dandeeAndy/CapstoneDesign/UI기본.png

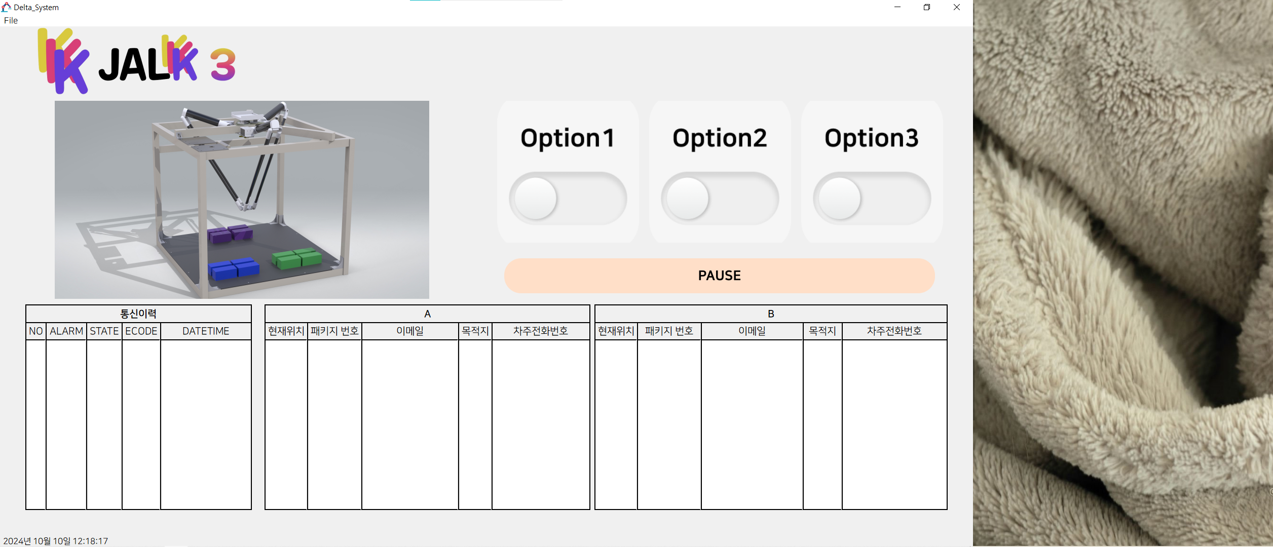
UI기본.png
