dandeeAndy/CapstoneDesign/hanium/엑스포/KakaoTalk_20241204_135034565_04.jpg

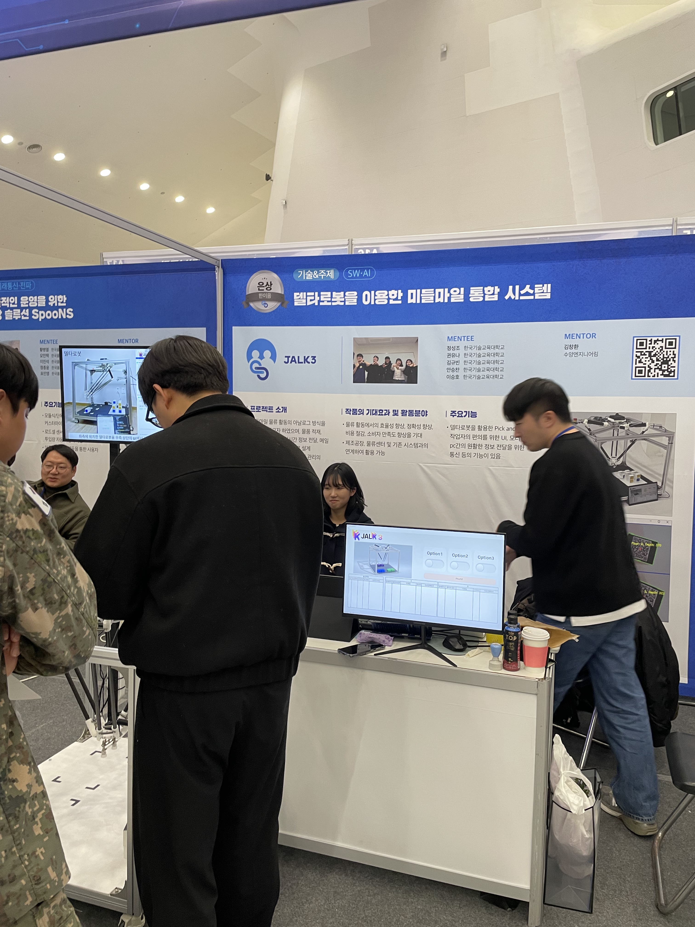
hanium/엑스포/KakaoTalk_20241204_135034565_04.jpg
