dandeeAndy/CapstoneDesign/Readme.txt

코드에 들어가는 (QPixmap)사진 파일 위치는 코드 안에서 다 특정할 수 있지만, 짧게 명료하게 쓰려면 같은 위치에 있어야 함.
->현재 디렉토리 확인 결과
C:\Users\schah\바탕 화면\Andy\Design\CapstoneDesign
