dandeeAndy/CapstoneDesign/한국기술교육대학교 산학협력단 사업자등록증_이규만.pdf

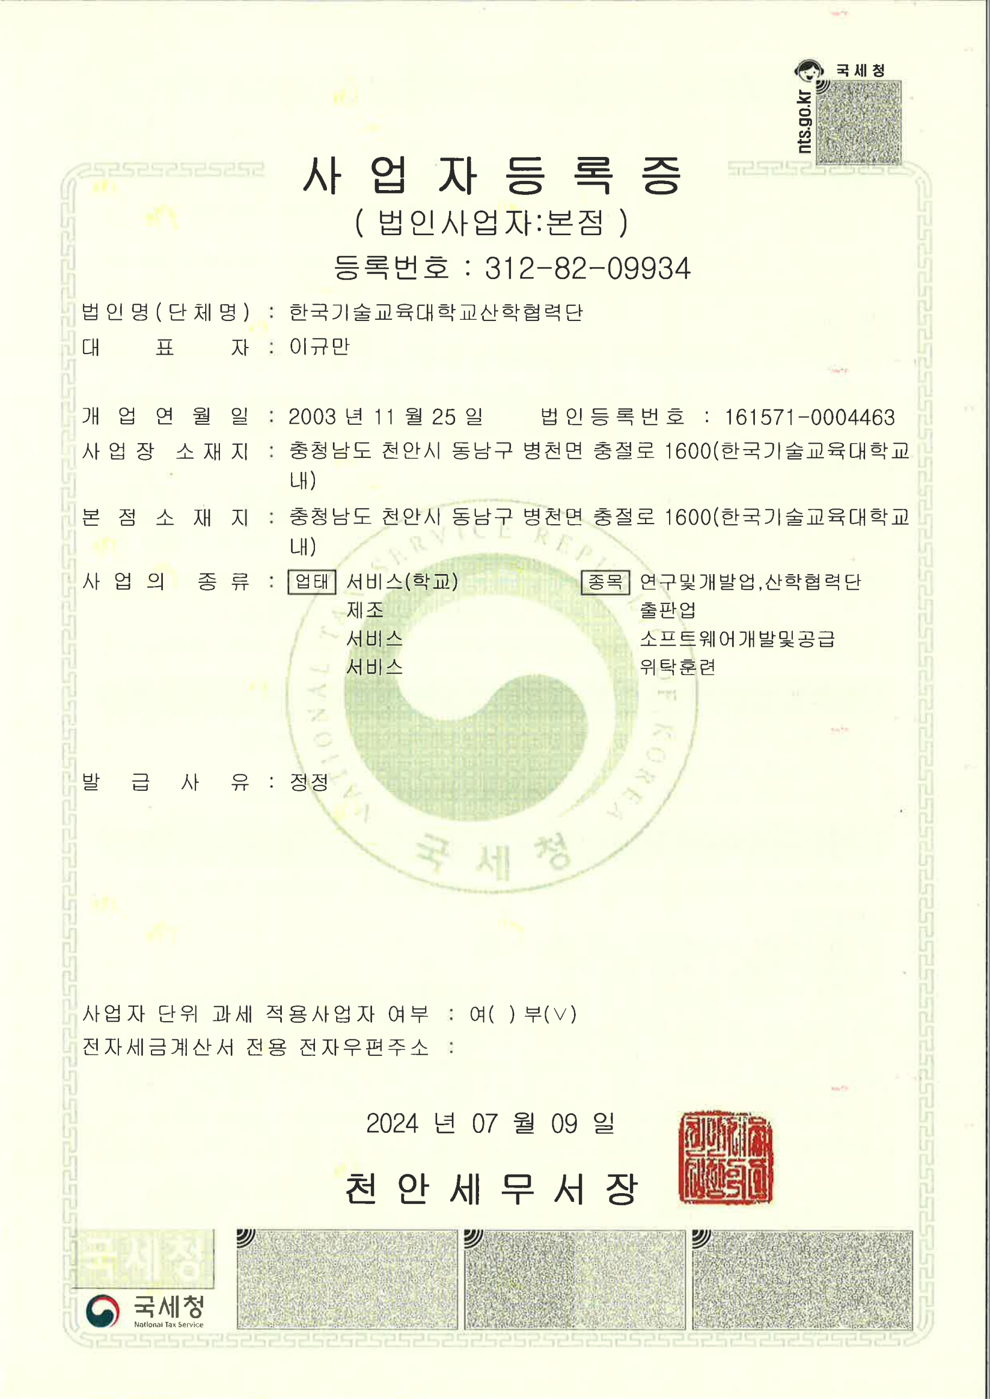
[picture p15: page 1]
