dandeeAndy/CapstoneDesign/hanium/ICT멘토링 레벨업 패스_이용 방법.pdf

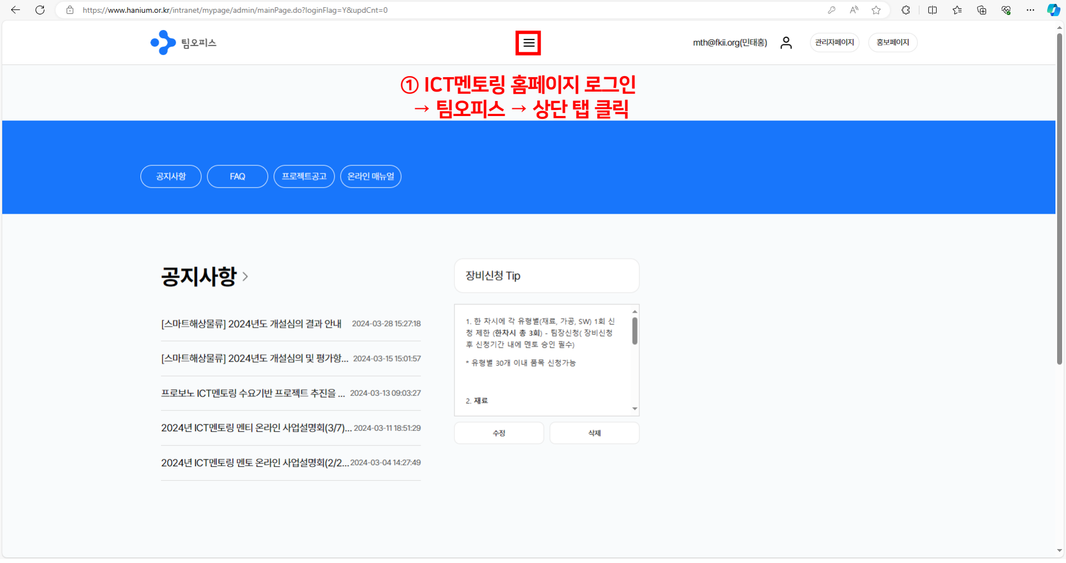
[picture p16: page 1]

① ICT멘토링 홈페이지 로그인
→ 팀오피스 → 상단 탭 클릭

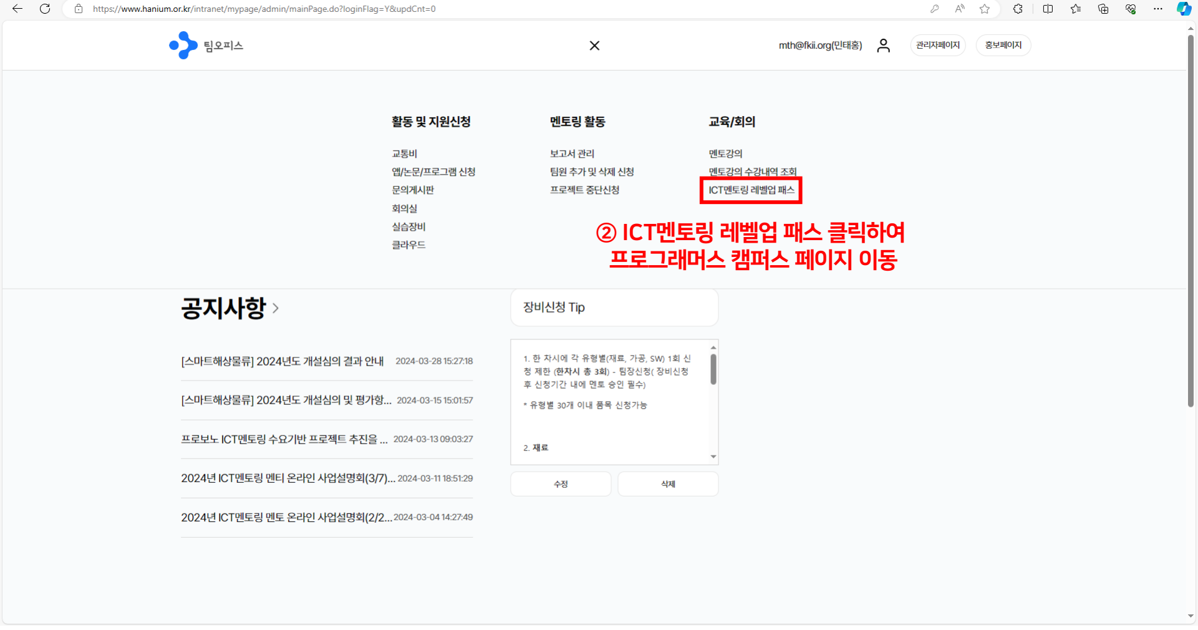
[picture p17: page 2]

② ICT멘토링 레벨업 패스 클릭하여
프로그래머스 캠퍼스 페이지 이동

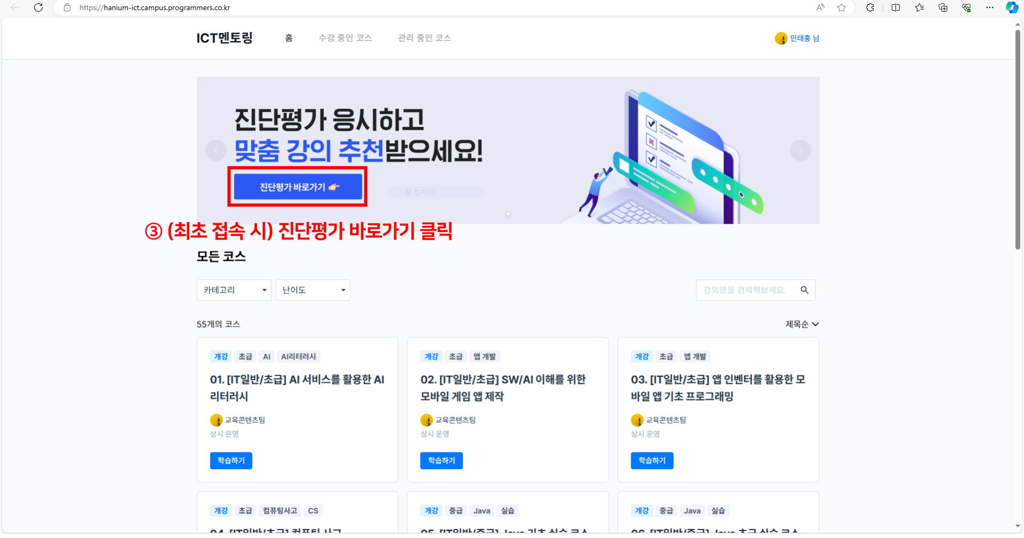
[picture p18: page 3]

③ (최초 접속 시) 진단평가 바로가기 클릭

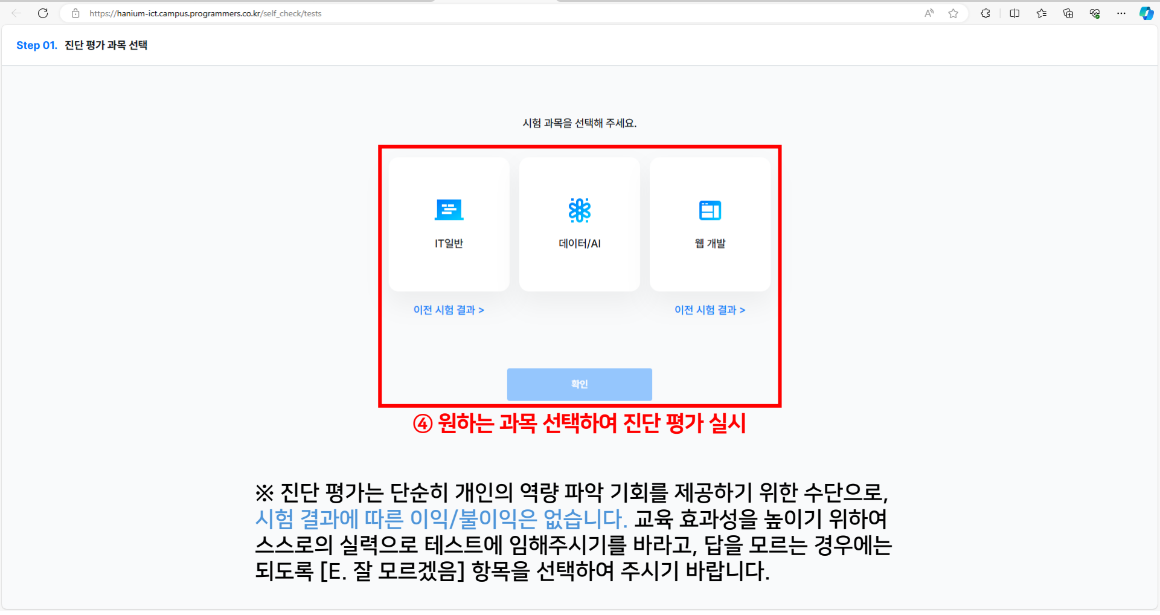
[picture p19: page 4]

④ 원하는 과목 선택하여 진단 평가 실시

※ 진단 평가는 단순히 개인의 역량 파악 기회를 제공하기 위한 수단으로, 시험 결과에 따른 이익/불이익은 없습니다. 교육 효과성을 높이기 위하여 스스로의 실력으로 테스트에 임해주시기를 바라고, 답을 모르는 경우에는 되도록 [E. 잘 모르겠음] 항목을 선택하여 주시기 바랍니다.

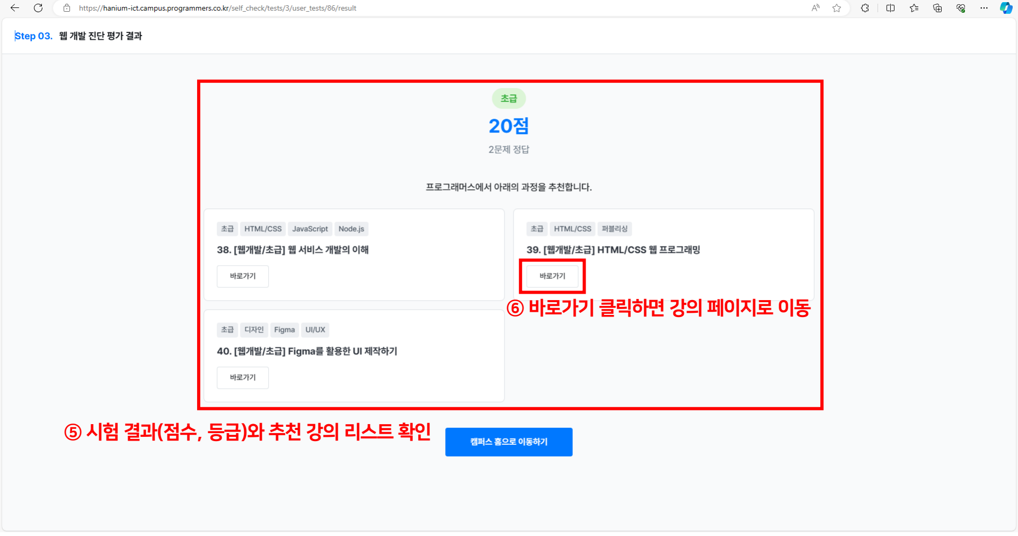
[picture p20: page 5]

⑤ 시험 결과(점수, 등급)와 추천 강의 리스트 확인

⑥ 바로가기 클릭하면 강의 페이지로 이동

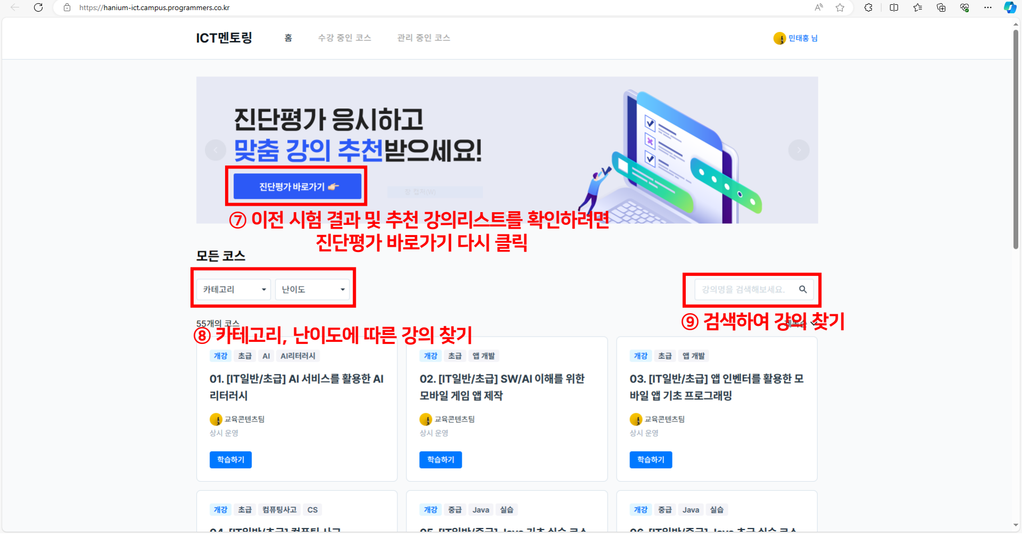
[picture p21: page 6]

⑧ 카테고리, 난이도에 따른 강의 찾기 | ⑨ 검색하여 강의 찾기

⑦ 이전 시험 결과 및 추천 강의리스트를 확인하려면
진단평가 바로가기 다시 클릭

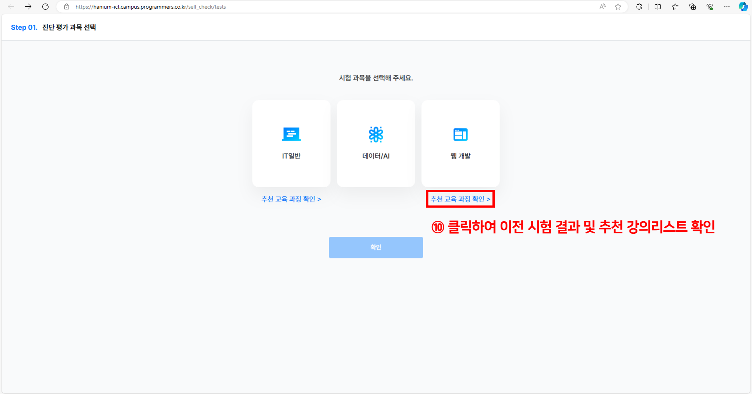
[picture p22: page 7]

⑩ 클릭하여 이전 시험 결과 및 추천 강의리스트 확인
