dandeeAndy/CapstoneDesign/기타파일/20240403(권유나님)견적서-아랫링크.pdf

NO : 20240403-D002

# 견 적 서

PAGE: | 1 / 1
권유나 귀하 견적일자 : 2024-04-03 견적요청에 감사드리며 아래 와 같이 견적합니다. | 공 급 자 | 등록번호 | 411-81-75485
상 호 | 주식회사 카본메이크 | 성 명 | 신학민
주 소 | 경기도 화성시 동탄첨단산업1로 63-12 (영천동) 비즈타워 312호
업 태 | 제조업 | 종 목 | 강화플라스틱성형
전화번호 | 070-7527-3444 | 팩스번호 | 030-3344-44545
순번 | 품목명 | 규격 | 수량 | 단가 | 공급가액 | 세액 | 비고
1 | 아랫링크(가공 포함) | 14*12*560 mm | 6 | 20,000 | 120,000 | 12,000
합계 | 120,000 | 12,000
납기일자 | 납품장소
유효일자 | 결제조건

비 고

합계금액 : 일금 일십삼만이천 원정 (￦ 132,000) (부가세포함)
