dandeeAndy/CapstoneDesign/졸설마무리/주간연구일지/주간연구일지_5주차.pdf

## 주간 연구 일지

교과목명 | 졸업설계 | 교과코드 | MEG895 | 분반 | 06
연구과제명 | 델타로봇을 이용한 미들마일 통합시스템
주차계획일정 | 4월 1주차 / 사용자 인터페이스(UI) 구축 및 사용자 경험(UX) 개발
일 시 | 2023년 04월 01일 (월) ~ 04월 07일 (일)
팀 원 | 성 명(사유) | | | 비고
참석자 | 정성조, 이승호, 안승찬, 권유나, 김규빈
불참자 | - 회의
안건 (작업 주제) | 1. UI 사용목적 2. UI 주요기능 구성

회의
(작업)
내용
1. UI 사용목적
- 연구목적
1) 사용자가 물류의 분류를 능동적으로 실시간 제어하기 위해서 UI를 개발해
- 연구과제 수행 과정 및 방법
1) 파이썬을 이용해 통신을 하기 위해서는 PyQt5를 이용해 개발해야 함. 우선, 피그마 (Figma)를 이용해 각 버튼의 이미지를 제작. 2. UI 주요기능 구성

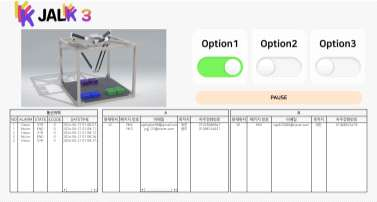
[picture p23: figure]

- UI가 실행되면 3가지 옵션 버튼을 누를 수 있게 함. 하나의 토글형 옵션 버튼을 누르 면 다른 옵션은 선택 불가하며, 바로 옵션에 따른 분류기준을 정해, 비전 카메라와 로봇 이 구동함. 아래의 구분된 ListLabel에 물류에 대한 정보가 한 줄씩 출력되어 도착위치와 함께 기록됨. 이후 작업 중지버튼을 누를시, 구동중인 루프만을 실행하고 비전 카메라와 로봇이 정지함. 이어 팝업된 리셋에 대한 안내창에서 ‘예’를 클릭시 옵션과 기록된 물류 정보를 모두 지우고 초기 상태로 돌아감. 추가로 모든 구동간에 비전 카메라 구동의 시 작과 모터 구동의 마무리 시점을 모두 기록해 통신이력을 남김. 결과/

지도교수 피드백

작성자 | 정성조 (인, 서명) | 지도교수 | 박성제 (인, 서명)
