dandeeAndy/CapstoneDesign/hanium/엑스포/KakaoTalk_20241204_165636019_14.jpg

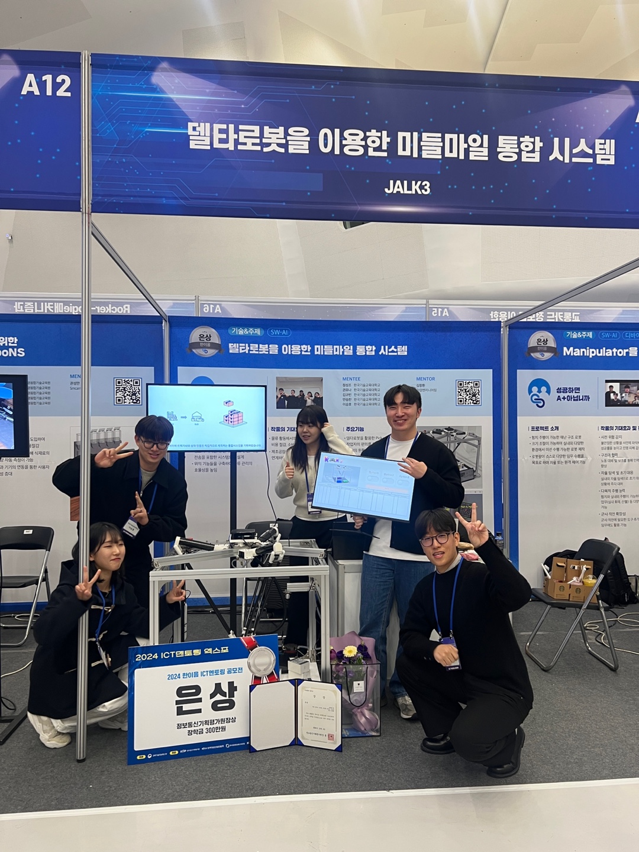
hanium/엑스포/KakaoTalk_20241204_165636019_14.jpg
