dandeeAndy/CapstoneDesign/hanium/엑스포/KakaoTalk_20241204_174310532.jpg

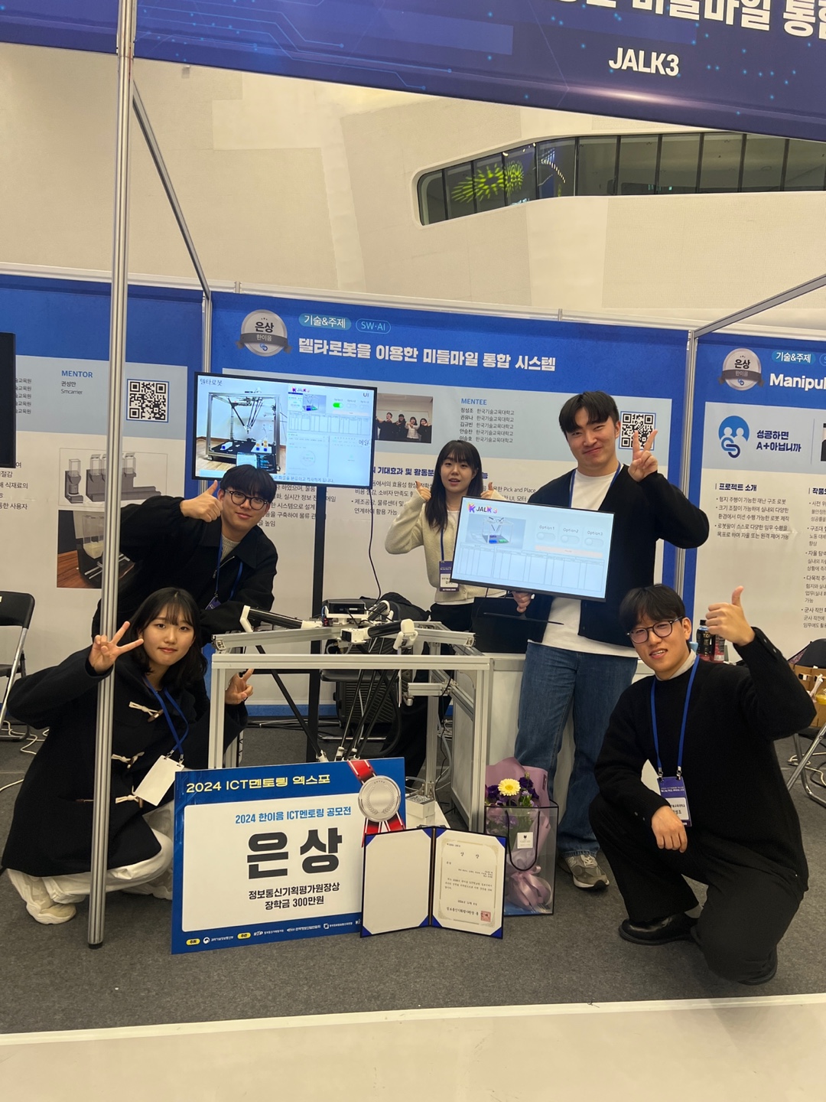
hanium/엑스포/KakaoTalk_20241204_174310532.jpg
