dandeeAndy/CapstoneDesign/hanium/엑스포/ktx영수증.png

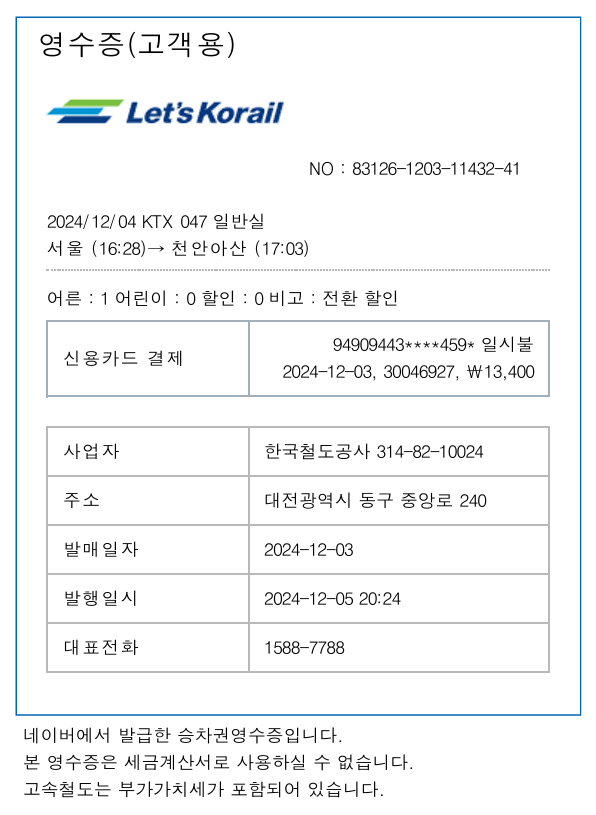
hanium/엑스포/ktx영수증.png
