dandeeAndy/CapstoneDesign/hanium/엑스포/Receipt_1733665486213.jpg

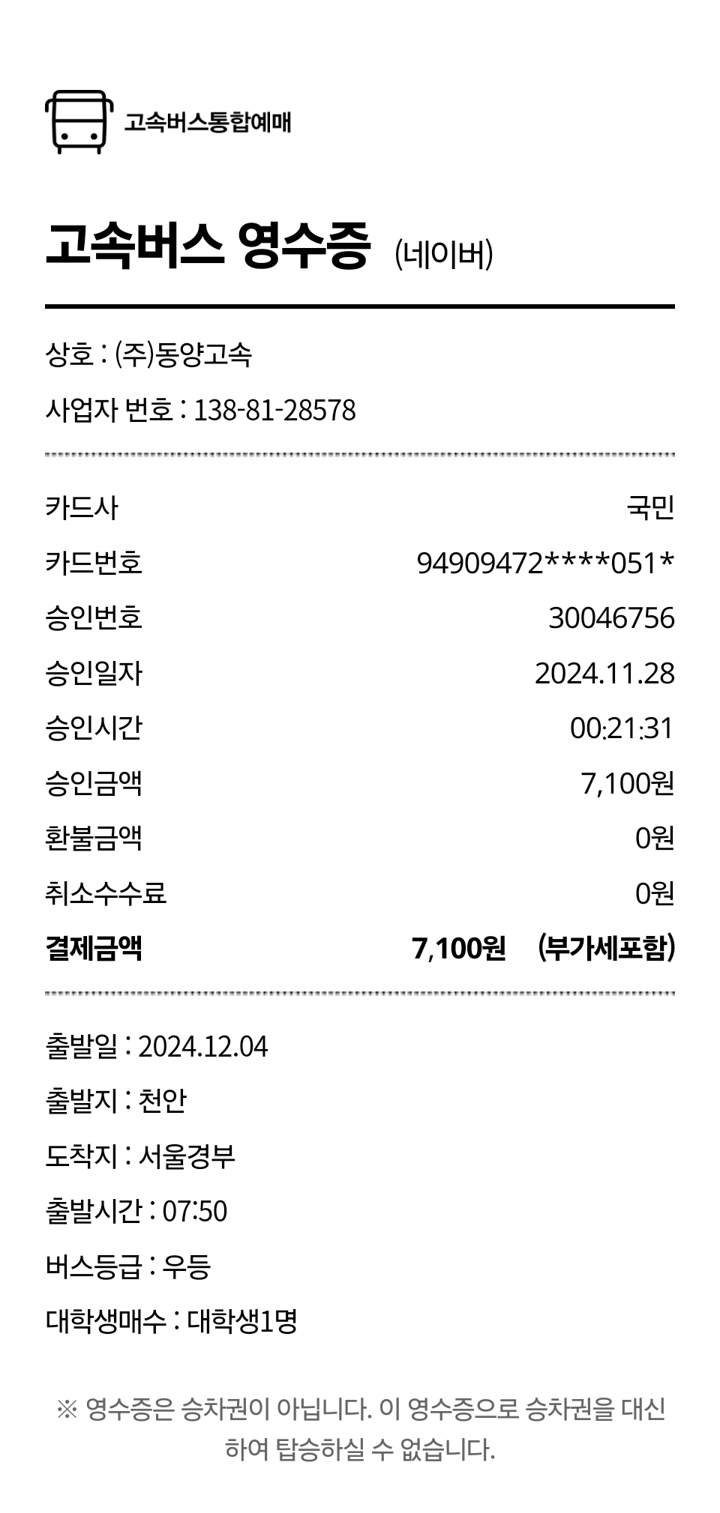
hanium/엑스포/Receipt_1733665486213.jpg
