dandeeAndy/CapstoneDesign/hanium/엑스포/Screenshot_20241208_225258_NAVER Map.jpg

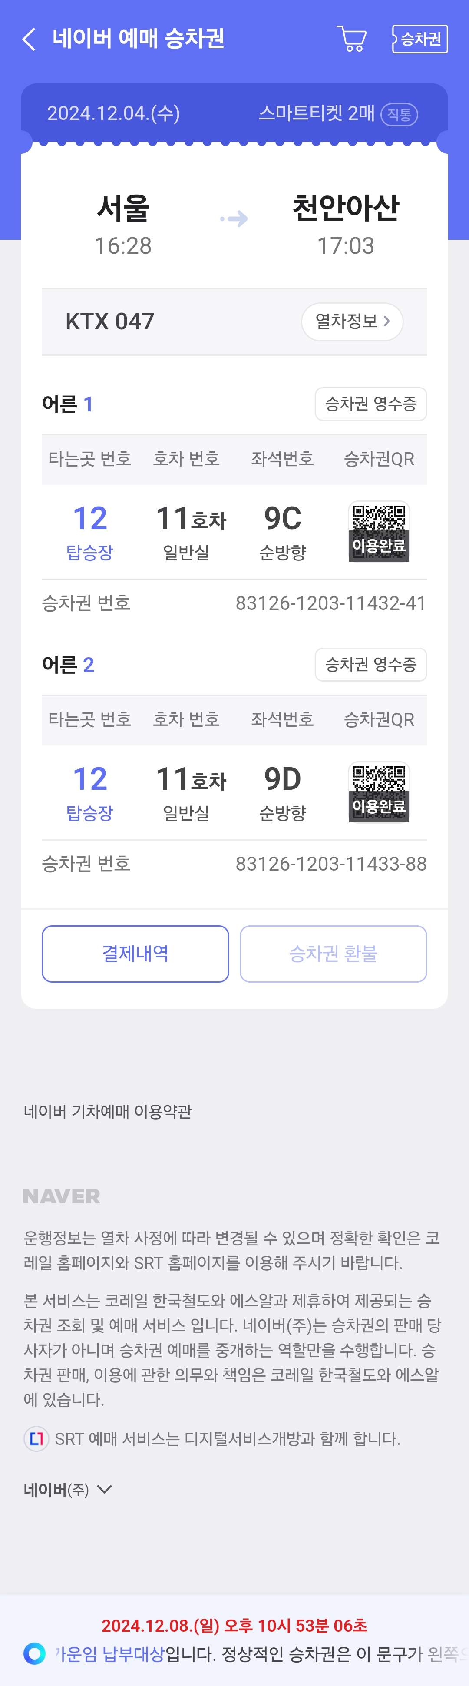
hanium/엑스포/Screenshot_20241208_225258_NAVER Map.jpg
