dandeeAndy/CapstoneDesign/hanium/엑스포/Ticket_1733665892753.jpg

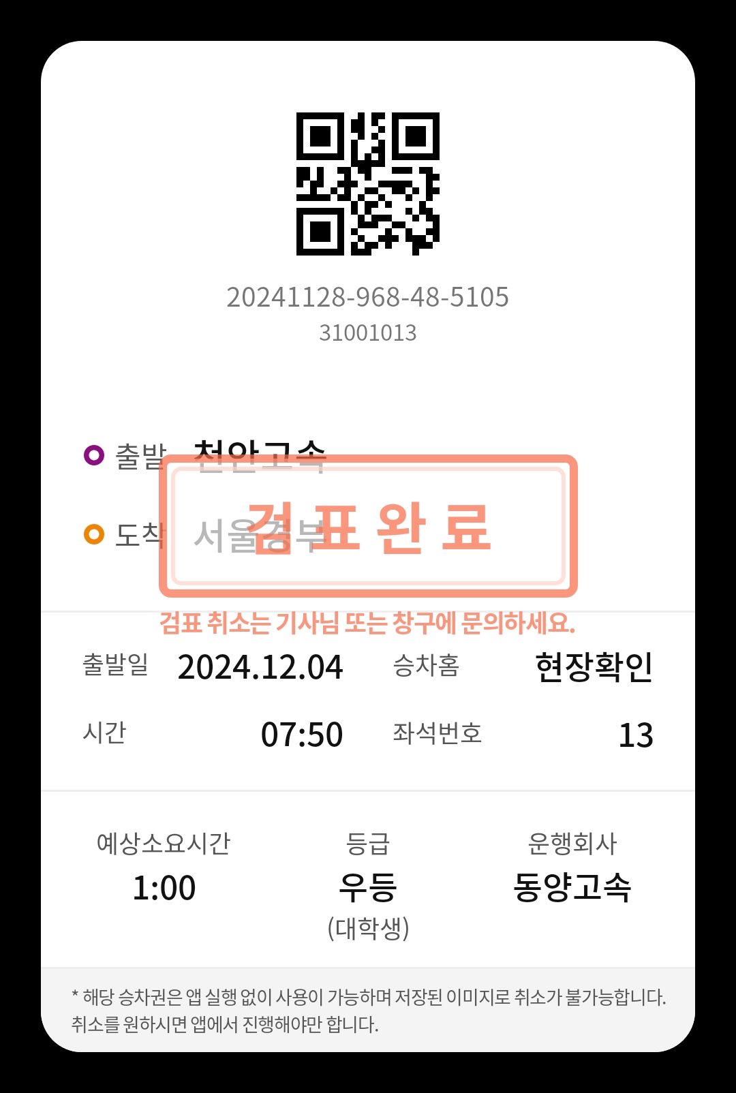
hanium/엑스포/Ticket_1733665892753.jpg
