dandeeAndy/CapstoneDesign/hanium/엑스포/계좌개설확인서_1733664481.png

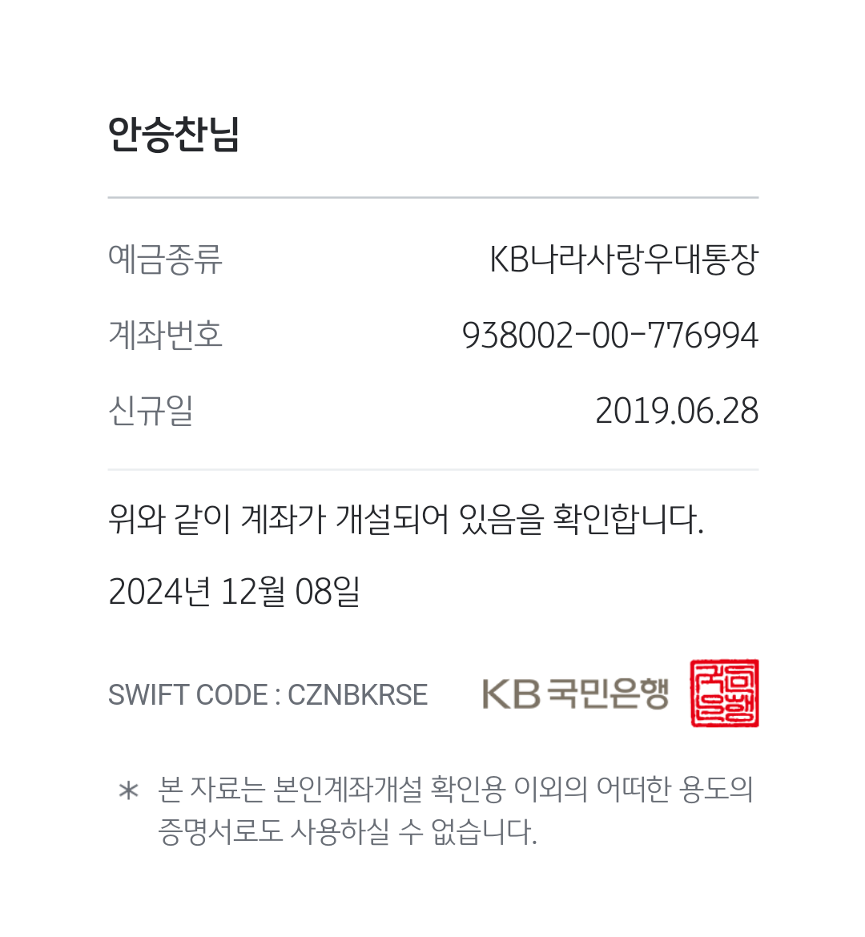
hanium/엑스포/계좌개설확인서_1733664481.png
