dandeeAndy/CapstoneDesign/hanium/엑스포/티켓+영수증.jpg

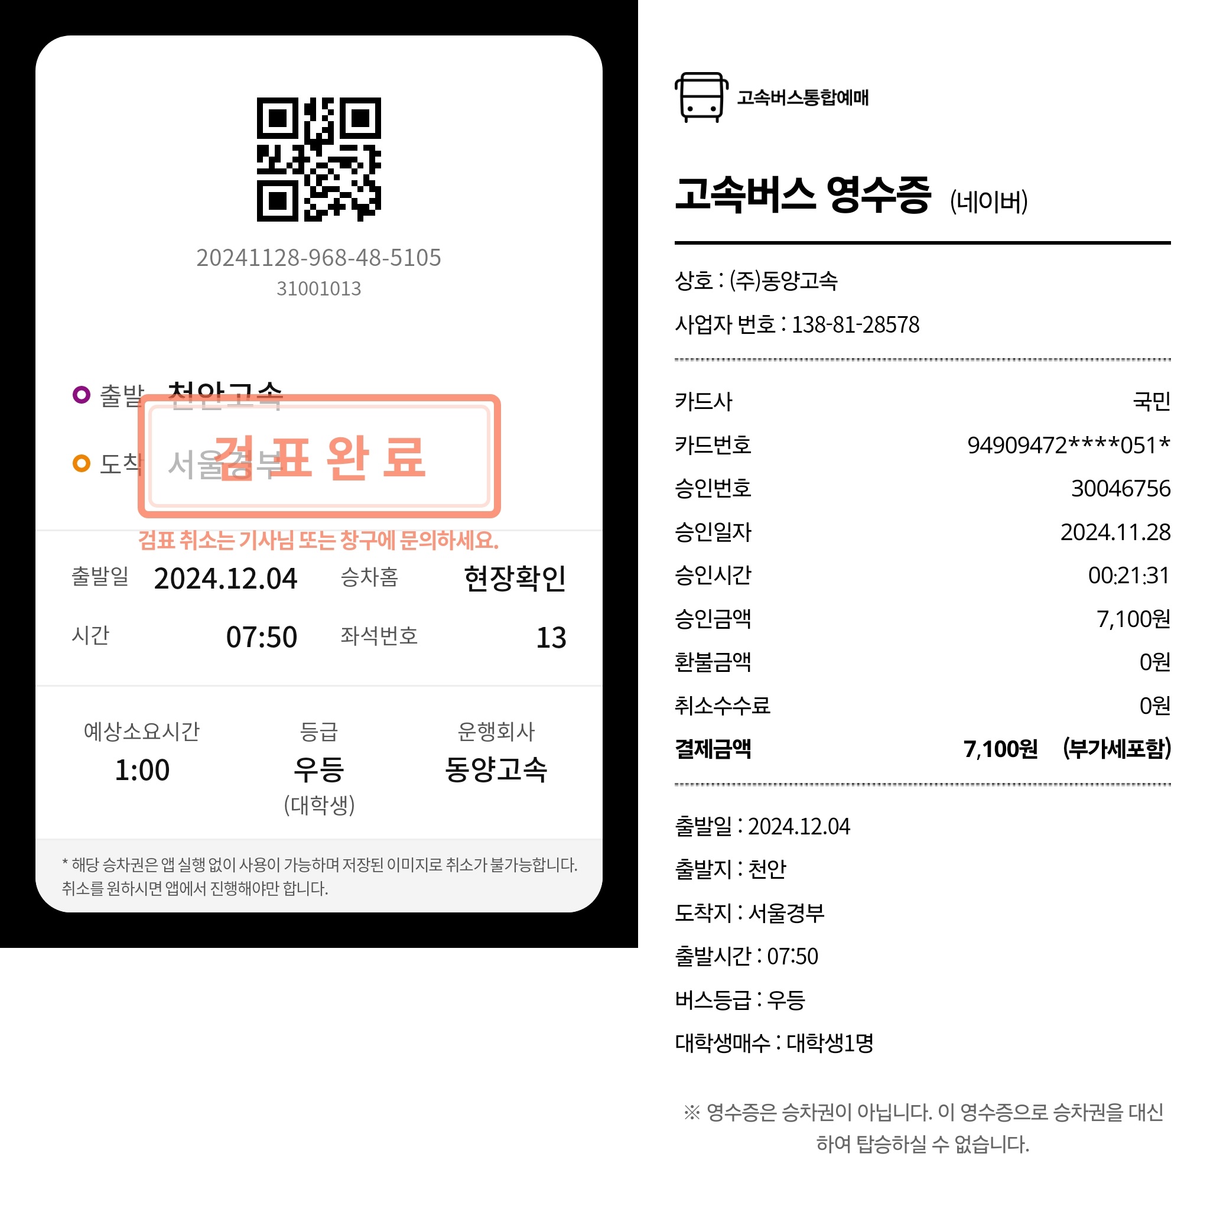
hanium/엑스포/티켓+영수증.jpg
