dandeeAndy/CapstoneDesign/UI/ABCD위치_A누끼.png

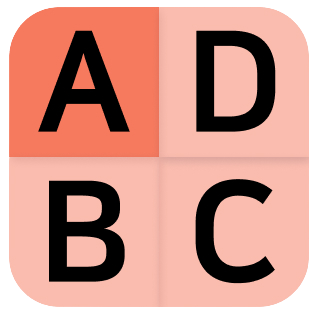
UI/ABCD위치_A누끼.png
