dandeeAndy/CapstoneDesign/UI/ABCD위치_C누끼.png

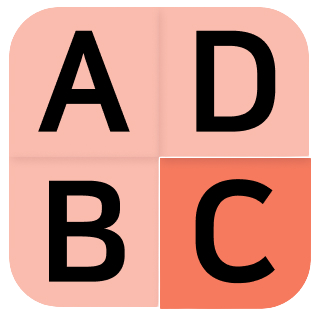
UI/ABCD위치_C누끼.png
