dandeeAndy/CapstoneDesign/UI/delta_total.png

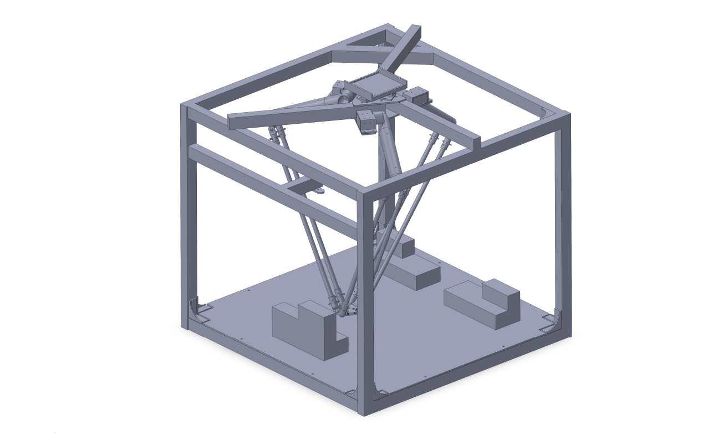
UI/delta_total.png
