dandeeAndy/CapstoneDesign/UI/mirobot2.png

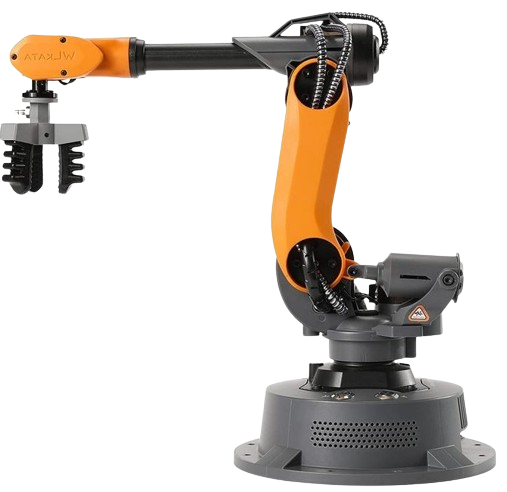
UI/mirobot2.png
