dandeeAndy/CapstoneDesign/UI/그림자포함운송수단_ON.png

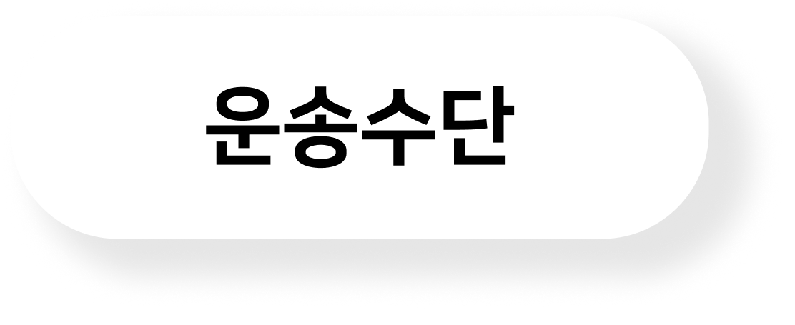
UI/그림자포함운송수단_ON.png
