dandeeAndy/CapstoneDesign/UI/그림자포함택배사_ON.png

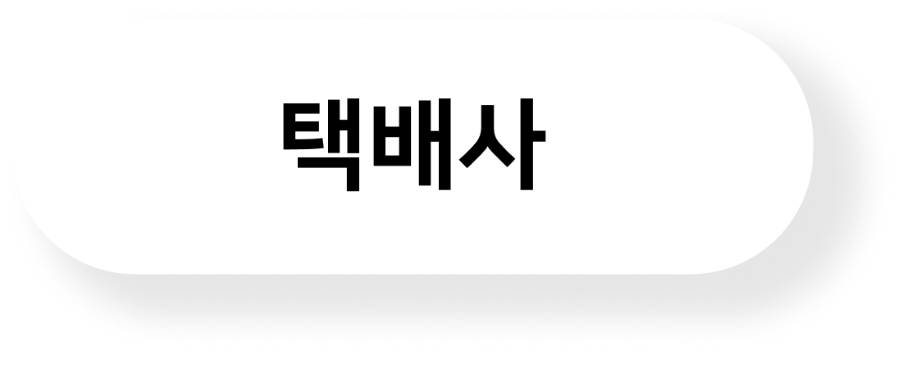
UI/그림자포함택배사_ON.png
