dandeeAndy/CapstoneDesign/UI/그림자포함파손주의_여부_ON.png

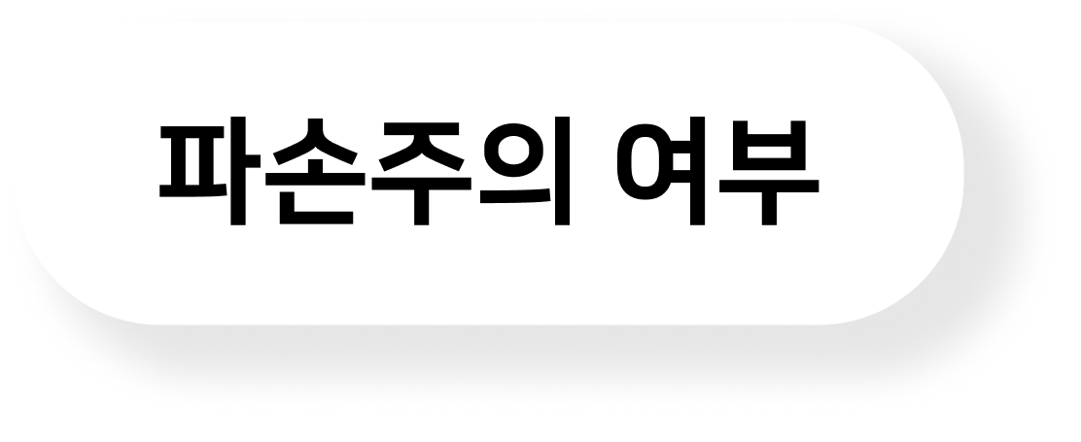
UI/그림자포함파손주의_여부_ON.png
