dandeeAndy/CapstoneDesign/UI/스팩공물 로봇앱.png

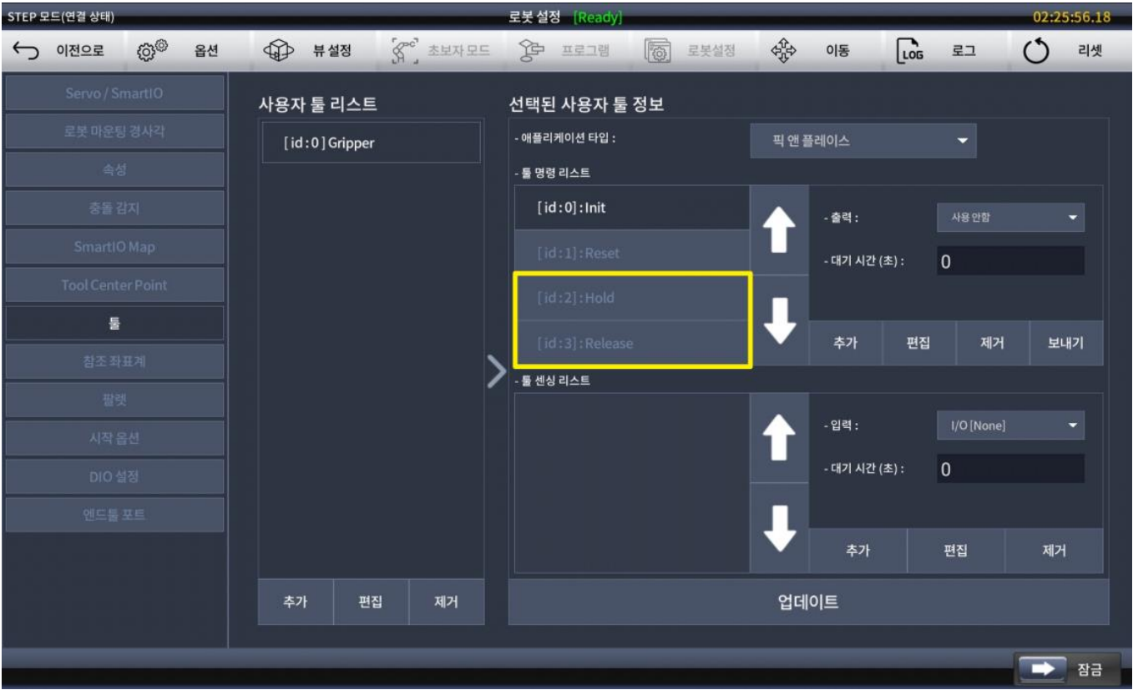
UI/스팩공물 로봇앱.png
