dandeeAndy/CapstoneDesign/UI_file/1111.png

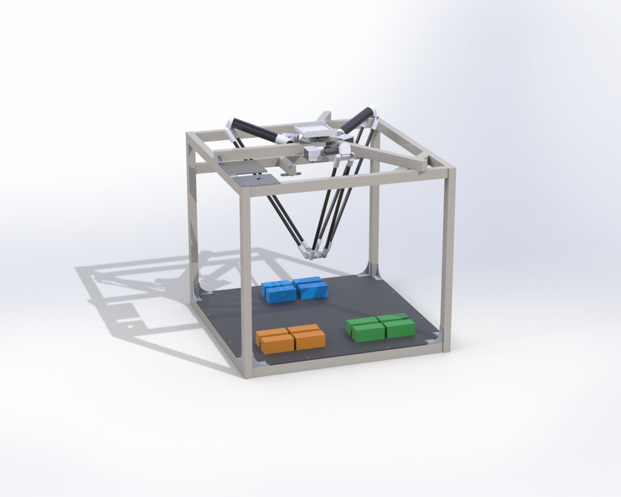
UI_file/1111.png
