dandeeAndy/CapstoneDesign/UI_file/opt1_OFF.png

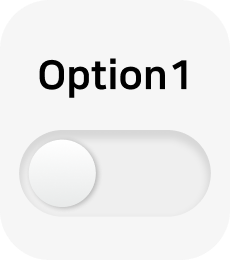
UI_file/opt1_OFF.png
