dandeeAndy/CapstoneDesign/UI_file/opt1_ON.png

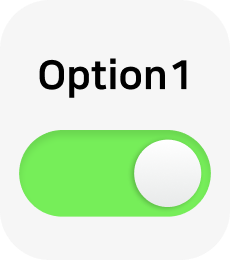
UI_file/opt1_ON.png
