dandeeAndy/CapstoneDesign/UI_file/pause_button.png

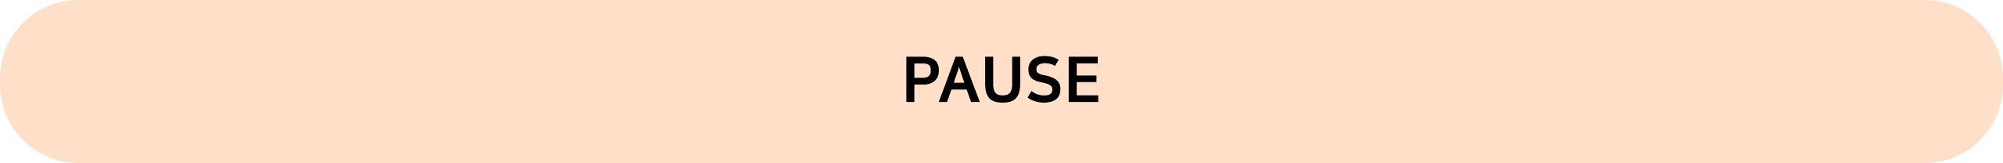
UI_file/pause_button.png
