dandeeAndy/CapstoneDesign/기타파일/한이음사진/델타로봇.png

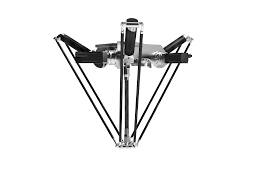
기타파일/한이음사진/델타로봇.png
