dandeeAndy/CapstoneDesign/기타파일/한이음사진/흐름도.jpg

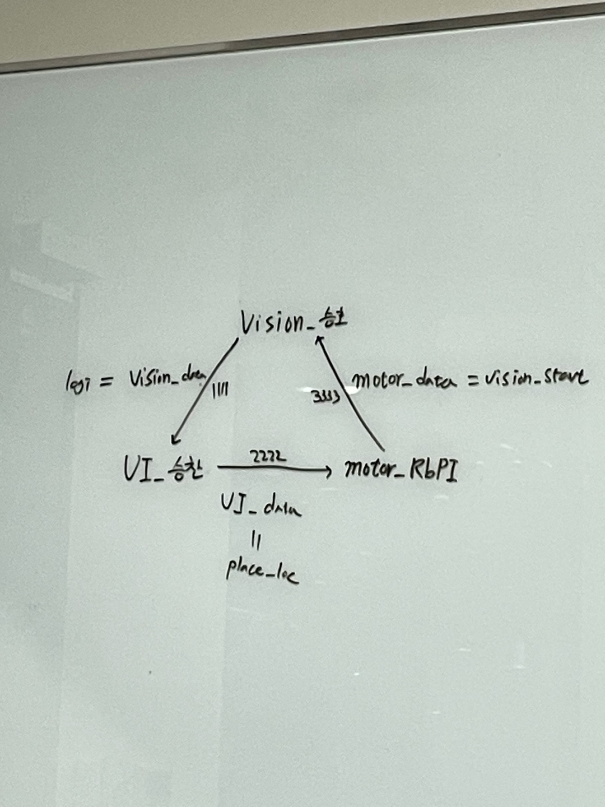
기타파일/한이음사진/흐름도.jpg
