dandeeAndy/CapstoneDesign/다스코리아_기술영입.png

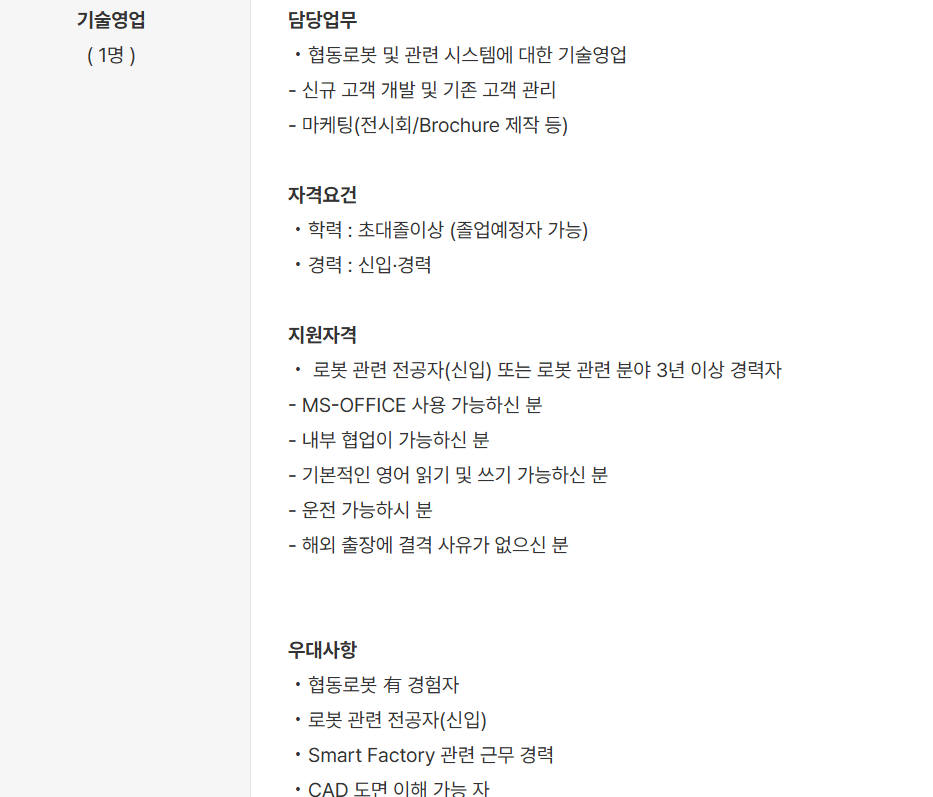
다스코리아_기술영입.png
