dandeeAndy/CapstoneDesign/델타로봇UI_초안.jpg

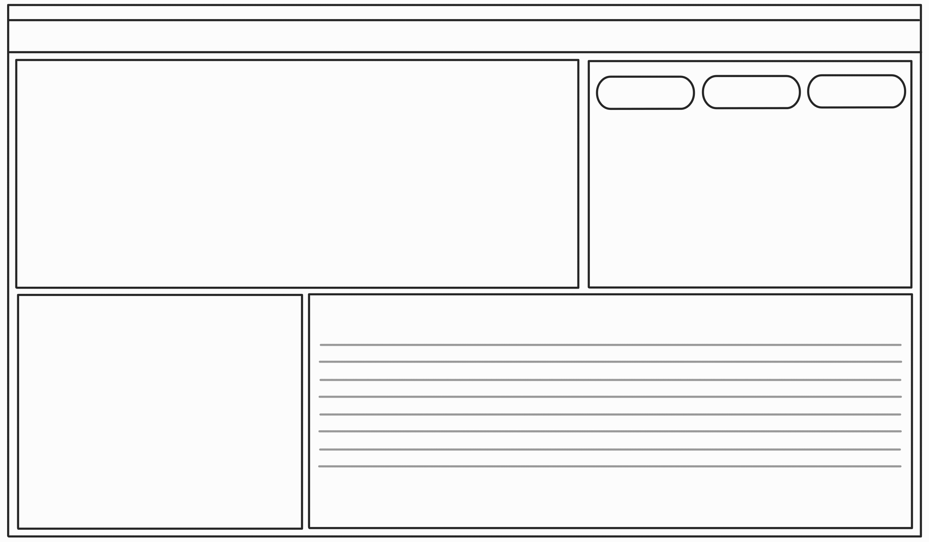
델타로봇UI_초안.jpg
