dandeeAndy/CapstoneDesign/메일 상세 내용.png

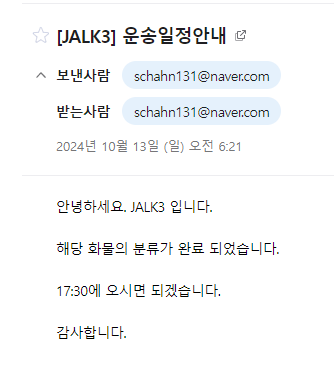
메일 상세 내용.png
