dandeeAndy/CapstoneDesign/메일 터미널 내용.png

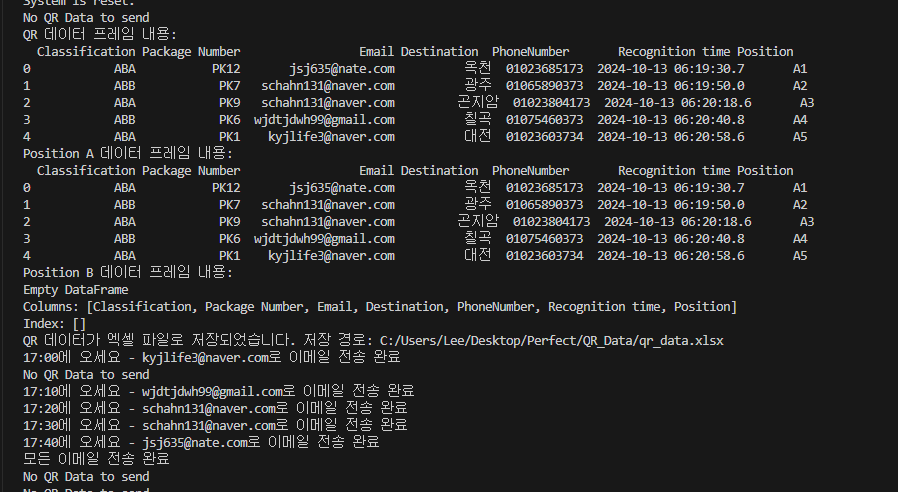
메일 터미널 내용.png
