dandeeAndy/CapstoneDesign/병렬프로그래밍방법.png

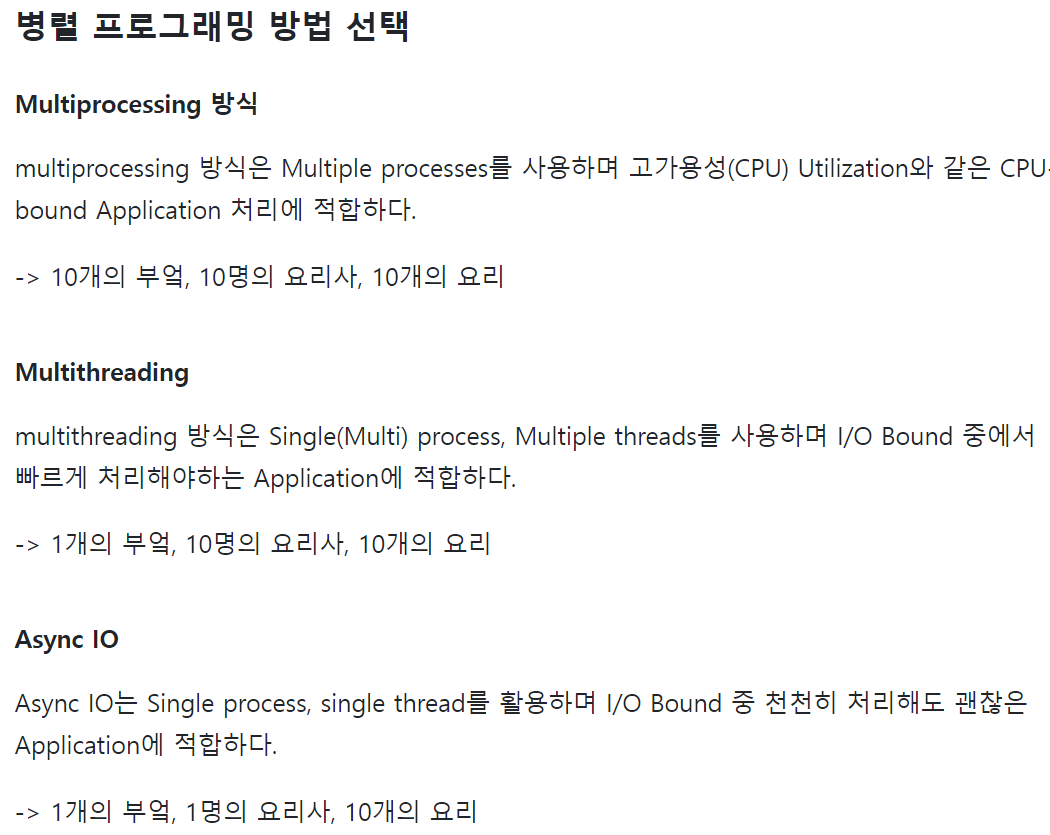
병렬프로그래밍방법.png
