dandeeAndy/CapstoneDesign/통신이력_정보_기록.png

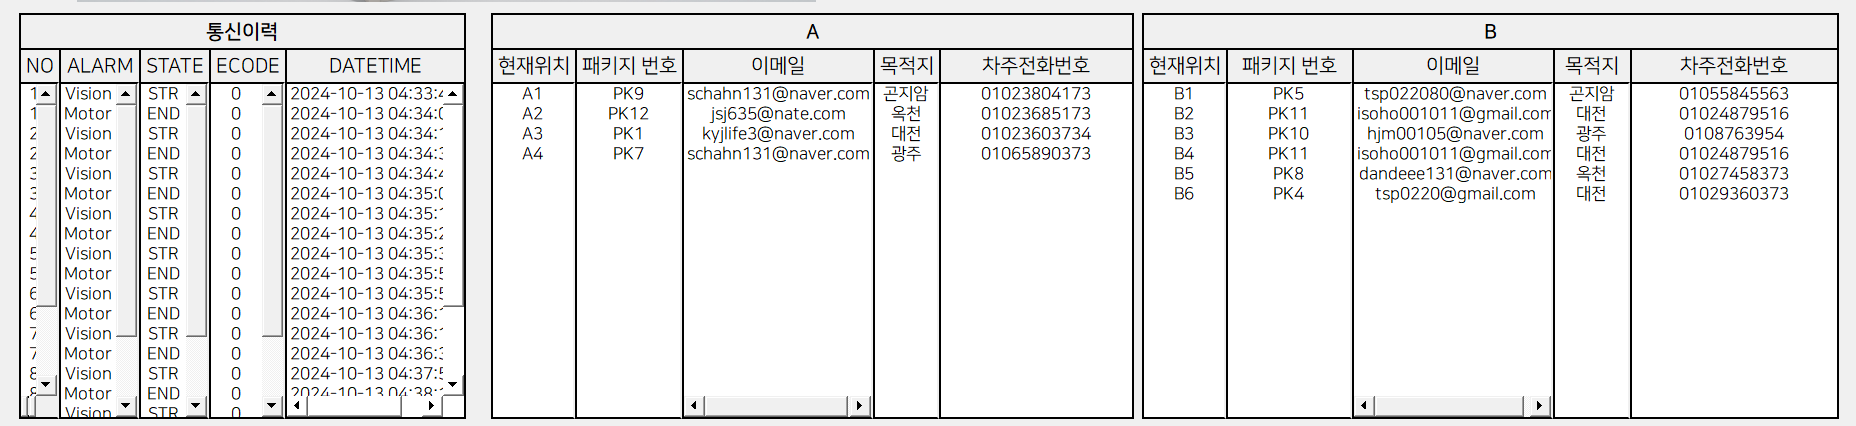
통신이력_정보_기록.png
