dandeeAndy/CapstoneDesign/통신이력_정보_기록_큰화면.png

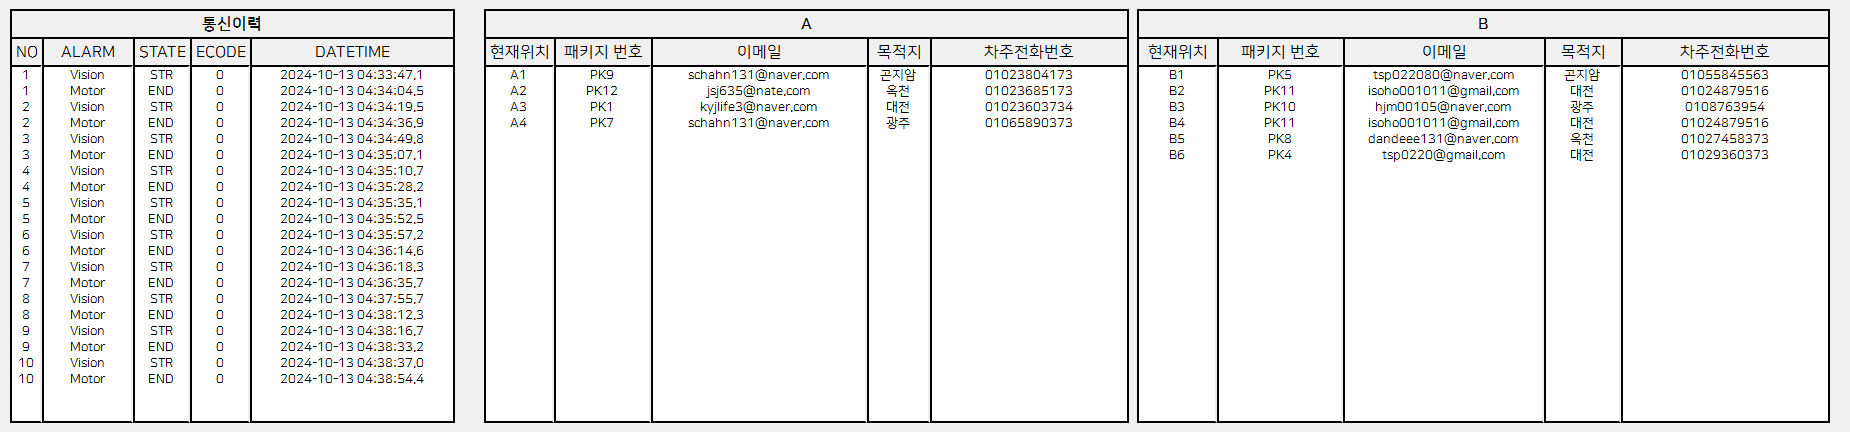
통신이력_정보_기록_큰화면.png
