dandeeAndy/CapstoneDesign/폐기/123층_1.jpg

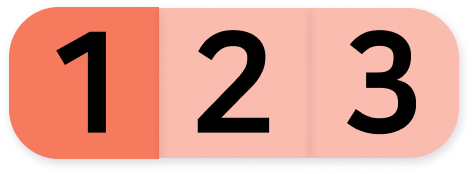
폐기/123층_1.jpg
