dandeeAndy/CapstoneDesign/폐기/123층_2.jpg

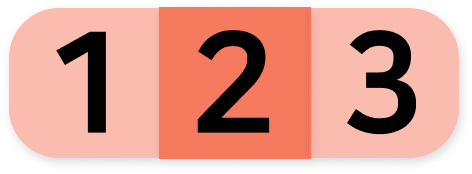
폐기/123층_2.jpg
