dandeeAndy/CapstoneDesign/폐기/123층_3.jpg

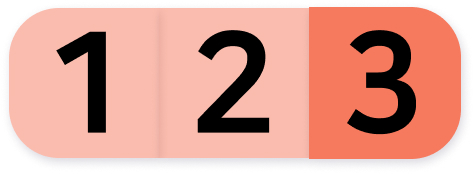
폐기/123층_3.jpg
