dandeeAndy/CapstoneDesign/기타파일/졸업설계소요재료신청서(한이음).xlsx

졸업설계 소요재료 신청서
학부(과)명: 기계공학부 |  |  |  |  |  |  |  | 2024학년도
졸업설계 과제명(국) |  | 델타로봇을 이용한 팔레타이징
팀장의 이름 / 연락처 |  | 정성조 / 010-5596-4794 |  |  |  |  | 지도교수 | 박성제
 | 수령인 성명 / 연락처: | 팀장이 아닌 경우에만 기재하세요.
No | 물 품 명 | 단 위 | 수 량 | 구매 단가 | 구매 금액 | 물품구매 사이트 주소 (URL)
1 | XM540-W270-T | 개 | 2 | 508200 | 1016400 | https://www.devicemart.co.kr/goods/view?no=13201635
2 | 카본파이프 외경14X내경12 길이 : 1200mm **추가가공(견적서 참고) : 14X12파이프 560mm 6개절단 후 구멍 가공 | 개 | 3 | 44000 | 132000 | http://carbonmake.co.kr/shop/list.php?goPage=GoodDetail&idx=1242&cat_no=67
3 | 카본파이프 외경40X내경36 길이 : 1000mm **추가가공(견적서 참고) : 40X36파이프 188mm 3개절단 후 구멍 가공 | 개 | 1 | 115500 | 115500 | http://carbonmake.co.kr/shop/list.php?goPage=GoodDetail&idx=430&cat_no=70
4 | 경제형 흡착홀더 MV시리즈 벨로즈패드 형번 : E-MVBKE20 홀더세트 / 실리콘 고무 / 직경 20 | 개 | 1 | 22594 | 22594 | https://kr.misumi-ec.com/vona2/detail/110310630179/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
5 | 테프론튜브 (실리콘) 상품번호 : 1289253 제조사 : SMG-A 사이즈 : 7x10 | 개 | 1 | 9850 | 9850 | https://www.devicemart.co.kr/goods/view?no=1289253
 |  |  |  | 합 계: | 1296344 | 구매사이트 업체 최소화 (배송비 절약 및 빠른 수령) 구매사이드의 재고수량 확인 해외배송 배제(국내에 없거나 가격이 싸지만 배송 문제) (배송에 1개월 이상 소요되므로 국내의 물품으로 대체)
P.S.: 구매 시에 참고해야 할 사항이나 요청내용이 있는 경우에만 간단하게 기술하시오.
 | 수령일자: |  | 수령자:
