dandeeAndy/CapstoneDesign/기타파일/졸업설계소요재료신청서（정성조）.xlsx

졸업설계 소요재료 신청서
학부(과)명: 기계공학부 |  |  |  |  |  |  |  | 2024학년도
졸업설계 과제명(국) |  | 델타로봇을 이용한 팔레타이징
팀장의 이름 / 연락처 |  | 정성조 / 010-5596-4794 |  |  |  |  | 지도교수 | 박성제
 | 수령인 성명 / 연락처: | 팀장이 아닌 경우에만 기재하세요.
No | 물 품 명 | 규 격 | 단 위 | 수 량 | 구매 단가 | 구매 금액 | 물품구매 사이트 주소 (URL)
1 | 인장스프링 | 인장 스프링 -중중하중/중하중 타입- 브랜드 : 미스미(MISUMI) 형번 : AWT20-60 외경D(pi) : 20 RoHS : 10 | 개 | 6 | 2773.37 | 16640.22 | https://kr.misumi-ec.com/vona2/detail/110302288510/?searchFlow=results2products&list=PageSearchResult
2 | 프로파일 DF3040 | [모델명]DF3040 [재질]A6N01S-T5orA6063S-T5 [규격]30*40*6050mm 절단 : 850mm | 개 | 4 | 7573 | 30292 | https://profileok.com:59110/shop/item.php?it_id=1200000013
 |  | [모델명] DF3040 [재질] A6N01S-T5 or A6063S-T5 [규격] 30 * 40 * 6050mm 절단 : 720mm | 개 | 4 | 6523 | 26092
 |  | [모델명]DF3040 [재질]A6N01S-T5orA6063S-T5 [규격]30*40*6050mm 절단 : 740mm | 개 | 4 | 6693 | 26772
 |  | [모델명] DF3040 [재질] A6N01S-T5 or A6063S-T5 [규격] 30 * 40 * 6050mm 절단 : 410mm | 개 | 1 | 4023 | 4023
 |  | [모델명]DF3040 [재질]A6N01S-T5orA6063S-T5 [규격]30*40*6050mm 절단 : 390mm | 개 | 2 | 3863 | 7726
 |  | [모델명]DF3040 [재질]A6N01S-T5orA6063S-T5 [규격]30*40*6050mm 절단 : 254mm | 개 | 2 | 2763 | 5526
3 | 135도 AL브라켓 | 135도 AL브라켓 30/60용 모델명 : DAL 13525, 13555 | 개 | 6 | 2150 | 12900 | https://hitc.kr/shop/
4 | 판형 스틸 브라켓 | 다이케스팅 브라켓 2860(30용) 모델명 : DCB 2860 | 개 | 8 | 1200 | 9600
5 | 다이케스팅 브라켓 | 다이케스팅 브라켓 3025(30용) 모델명 : DCB 3025 | 개 | 44 | 500 | 22000
6 | 셈스렌치볼트 | 볼트 류: 셈스렌치볼트 M6x15 | 개 | 132 | 130 | 17160
 |  | 너트 류 : 정사각 너트 30 M6 | 개 | 132 | 50 | 6600
7 | 벨로즈패드 | 경제형 흡착홀더 MV시리즈 벨로즈패드 형번 : E-MVBKE20 브랜드: 미스미 (MISUMI) MISUMI economy 진공패드 - k형, 흡착패드 직경 20 | 개 | 1 | 18500.37 | 18500.37 | https://kr.misumi-ec.com/vona2/detail/110310630179/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
8 | 볼 스터드 | 앵글 조인트용 볼 스터드 모델명 : K0713.1006 D1(mm) : 10 D2(mm) : M6 타입 : C | 개 | 12 | 3784 | 45408 | https://www.navimro.com/g/211601/
9 | 카본파이프 | 카본파이프 외경40X내경36 길이 : 1000mm **추가가공(절단) : 40X36파이프 188mm 3개절단 | 개 | 1 | 79750 | 79750 | http://carbonmake.co.kr/shop/list.php?goPage=GoodDetail&idx=430&cat_no=70
10 | 카본파이프 | 카본파이프 외경14X내경12 길이 : 1200mm **추가가공(절단) : 14X12파이프 560mm 6개절단 | 개 | 3 | 27500 | 82500 | http://carbonmake.co.kr/shop/list.php?goPage=GoodDetail&idx=1242&cat_no=67
11 | 컴팩트 너트 | 형번 : PACK-SNTRC6 브랜드 : 미스미(MISUMI) 나사호칭(M) : 6 RoHS : 10 나사산 종류 : 미터일반나사 | 개 | 2 | 14268.37 | 28536.74 | https://kr.misumi-ec.com/vona2/detail/110301997310/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
12 | 육각렌치볼트 | 육각 홀 붙이 볼트(전나사, 반나사) 브랜드 : 산코(SUNCO) 형번 : CSH-SUS-M3-25 | 개 | 12 | 256.37 | 3076.44 | https://kr.misumi-ec.com/vona2/detail/221000551286/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
13 | 육각렌치볼트 | 육각 홀 붙이 볼트(전나사, 반나사) 브랜드 : 산코(SUNCO) 형번 : CSH-SUS-M3-45 | 개 | 12 | 441.37 | 5296.44 | https://kr.misumi-ec.com/vona2/detail/221000551286/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
14 | 테프론튜브 | 테프론튜브 (실리콘) 상품번호 : 1289253 제조사 : SMG-A 사이즈 : 7x10 | 개 | 1 | 7150 | 7150 | https://www.devicemart.co.kr/goods/view?no=1289253
15 | 나일론 너트 | 나일론 너트(1종) 브랜드 : 토모에(TOMOE) 형번 : NN1-M3-CB | 개 | 18 | 372.37 | 6702.66 | https://kr.misumi-ec.com/vona2/detail/221000608571/?searchFlow=results2products&list=PageSearchResult
16 | 진공펌프 | VaccumPump-12V ROB-10398 상품코드 : RS-018299 | 개 | 1 | 36910 | 36910 | https://www.devicemart.co.kr/goods/view?no=1313216
15 | 전원공급장치 | 유니온 SMPS 전원공급장치 AC-DC 12V 1.3A 15W (A-15NR-12) 브랜드 : 제노물 자체상품코드 : A-15NR-12 | 개 | 1 | 17700 | 17700 | https://www.jenomall.com/goods/goods_view.php?goodsNo=1000009174
 |  |  |  |  | 합 계: | 516861.87 | 구매사이트 업체 최소화 (배송비 절약 및 빠른 수령) 구매사이드의 재고수량 확인 해외배송 배제(국내에 없거나 가격이 싸지만 배송 문제) (배송에 1개월 이상 소요되므로 국내의 물품으로 대체)
P.S.: 구매 시에 참고해야 할 사항이나 요청내용이 있는 경우에만 간단하게 기술하시오.
 | 수령일자: |  | 수령자: |  | 정성조
