dandeeAndy/CapstoneDesign/hanium/Perfect/QR_Data/qr_data.xlsx

Sheet: QR Data
Classification | Package Number | Email | Destination | PhoneNumber | Recognition time | Position
BAB | PK9 | schahn131@naver.com | 청원 | 01055874444 | 2024-05-21 22:39:55.7 | B1
BAA | PK12 | jsj635@nate.com | 칠곡 | 01087455665 | 2024-05-21 22:40:07.8 | B2
BAB | PK10 | hjm00105@naver.com | 군포 | 01087452651 | 2024-05-21 22:40:20.0 | B3
ABA | PK6 | wjdtjdwh99@gmail.com | 옥천 | 01025688947 | 2024-05-21 22:40:32.2 | A1
AAA | PK7 | schahn131@naver.com | 칠곡 | 01025478955 | 2024-05-21 22:40:44.6 | A2
ABB | PK4 | tsp0220@gmail.com | 곤지암 | 01075642315 | 2024-05-21 22:40:56.8 | A3
ABA | PK3 | jsjjj123@naver.com | 광주 | 01098745621 | 2024-05-21 22:41:08.9 | A4
AAA | PK1 | kyjlife3@naver.com | 대전 | 01054657894 | 2024-05-21 22:41:21.5 | A5
BBA | PK11 | isho001011@gmail.com | 광주 | 01074852563 | 2024-05-21 22:41:34.0 | B4
AAB | PK2 | kyjlife16@gmail.com | 옥천 | 01024563515 | 2024-05-21 22:41:46.1 | A6
BAA | PK5 | tsp022080@naver.com | 대전 | 01068523479 | 2024-05-21 22:41:58.4 | B5
BAB | PK8 | dandeee131@naver.com | 곤지암 | 01095742364 | 2024-05-21 22:42:10.8 | B6

Sheet: Position A
Classification | Package Number | Email | Destination | PhoneNumber | Recognition time | Position
ABA | PK6 | wjdtjdwh99@gmail.com | 옥천 | 01025688947 | 2024-05-21 22:40:32.2 | A1
AAA | PK7 | schahn131@naver.com | 칠곡 | 01025478955 | 2024-05-21 22:40:44.6 | A2
ABB | PK4 | tsp0220@gmail.com | 곤지암 | 01075642315 | 2024-05-21 22:40:56.8 | A3
ABA | PK3 | jsjjj123@naver.com | 광주 | 01098745621 | 2024-05-21 22:41:08.9 | A4
AAA | PK1 | kyjlife3@naver.com | 대전 | 01054657894 | 2024-05-21 22:41:21.5 | A5
AAB | PK2 | kyjlife16@gmail.com | 옥천 | 01024563515 | 2024-05-21 22:41:46.1 | A6

Sheet: Position B
Classification | Package Number | Email | Destination | PhoneNumber | Recognition time | Position
BAB | PK9 | schahn131@naver.com | 청원 | 01055874444 | 2024-05-21 22:39:55.7 | B1
BAA | PK12 | jsj635@nate.com | 칠곡 | 01087455665 | 2024-05-21 22:40:07.8 | B2
BAB | PK10 | hjm00105@naver.com | 군포 | 01087452651 | 2024-05-21 22:40:20.0 | B3
BBA | PK11 | isho001011@gmail.com | 광주 | 01074852563 | 2024-05-21 22:41:34.0 | B4
BAA | PK5 | tsp022080@naver.com | 대전 | 01068523479 | 2024-05-21 22:41:58.4 | B5
BAB | PK8 | dandeee131@naver.com | 곤지암 | 01095742364 | 2024-05-21 22:42:10.8 | B6
