dandeeAndy/CapstoneDesign/기타파일/로봇파트_수정본_A1/A1_deltarobot_link_2.SLDASM

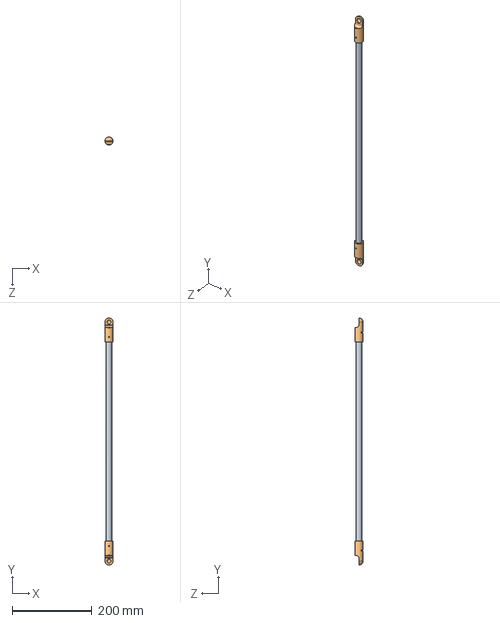
[picture p60: CAD file, 2024-04-09]
기타파일/로봇파트_수정본_A1/A1_deltarobot_link_2.SLDASM
20.0 x 620.0 x 20.0 mm
A1_아래링크
A1_아래링크_볼조인트_연결부 x 2
