dandeeAndy/CapstoneDesign/기타파일/로봇파트_수정본_A2/A1_deltarobot_link_1.SLDASM

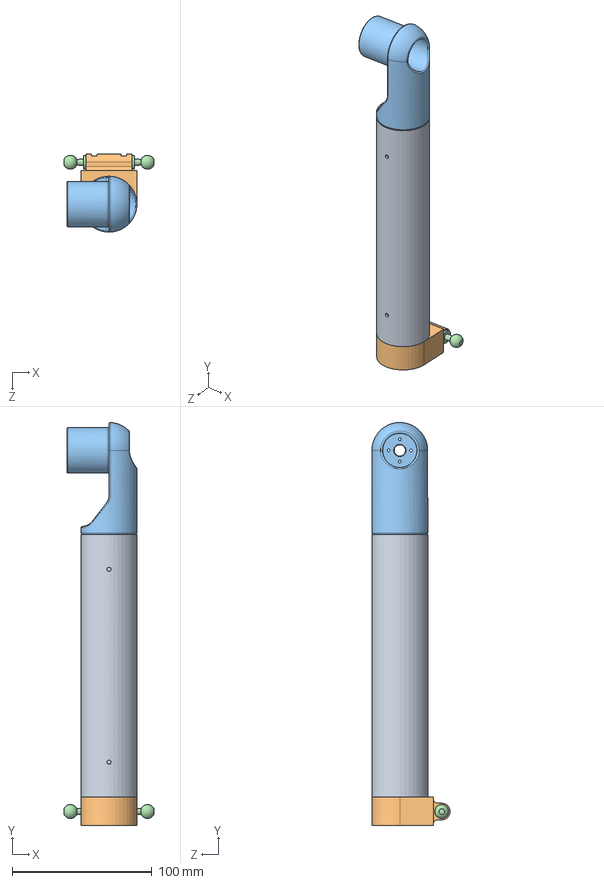
[picture p61: CAD file, 2024-04-09]
기타파일/로봇파트_수정본_A2/A1_deltarobot_link_1.SLDASM
64.4 x 288.2 x 56.0 mm
A1_윗링크_수정후_중간연결부
A1_윗링크_아래연결부
A1_윗링크_위쪽연결부
A1_볼조인트_진짜최종 x 2
