dandeeAndy/CapstoneDesign/기타파일/로봇파트_수정본_A1/A1_deltarobot_end.SLDASM

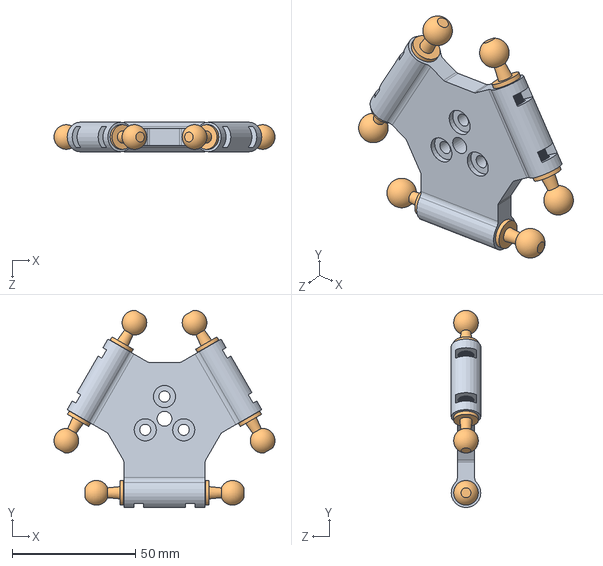
[picture p63: CAD file, 2024-04-09]
기타파일/로봇파트_수정본_A1/A1_deltarobot_end.SLDASM
89.6 x 79.9 x 12.0 mm
A1_아랫삼각형
A1_볼조인트_진짜최종 x 6
