dandeeAndy/CapstoneDesign/기타파일/로봇파트_수정본_A1/A1_XC-430_idle.SLDASM

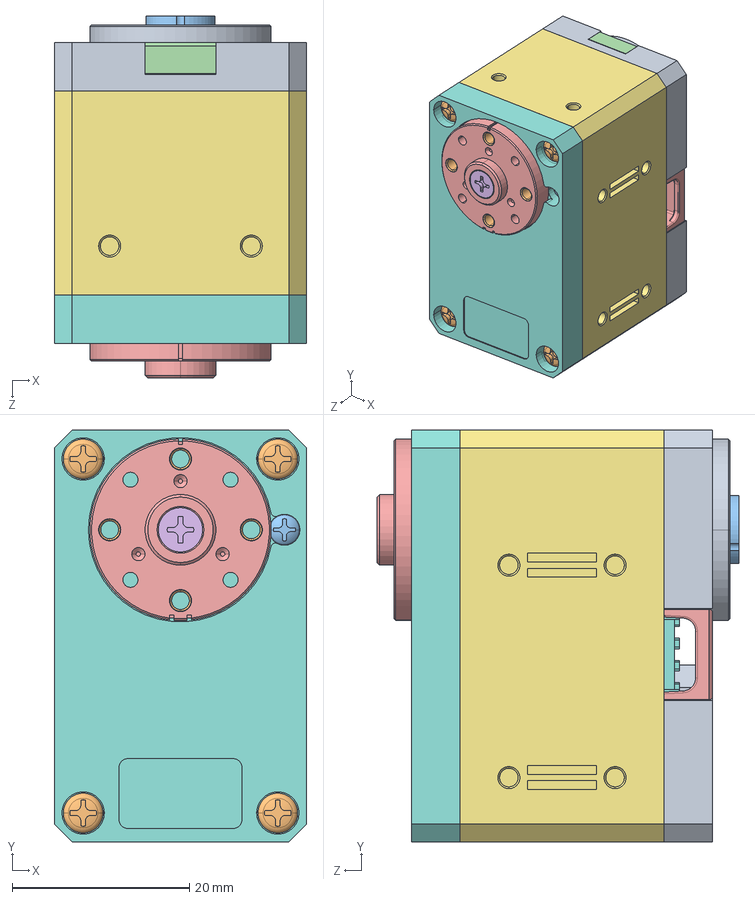
[picture p65: CAD file, 2024-04-09]
기타파일/로봇파트_수정본_A1/A1_XC-430_idle.SLDASM
28.5 x 46.5 x 40.9 mm
M_DC11_A01_IDLER.stp
DC11_A01_HORN_INSERT_1.stp x 8
M_DC11_A01_IDLER_CAP.stp
DC11_A01_IDLER_SCREW.stp
M_DC11_A01_HORN.stp
FHS_M2_5X06_NYLOK.stp
DC11_B01_CASE_M_DUMMY.stp
DC11_B01_CASE_F_DUMMY.stp
DC11_B01_CASE_B_DUMMY2.stp
PHS_M2_5X12_K.stp x 8
DX124_SCREW-COVER.stp
DC11_A01_WIN_LED.stp
DC11_A01_CVR_CABLE.stp
DC14_A01_INSERT_1.stp
B3B-EH.stp x 2
EHR-3.stp x 2
