dandeeAndy/CapstoneDesign/기타파일/로봇파트_수정본_A2/A2_deltarobot.SLDASM

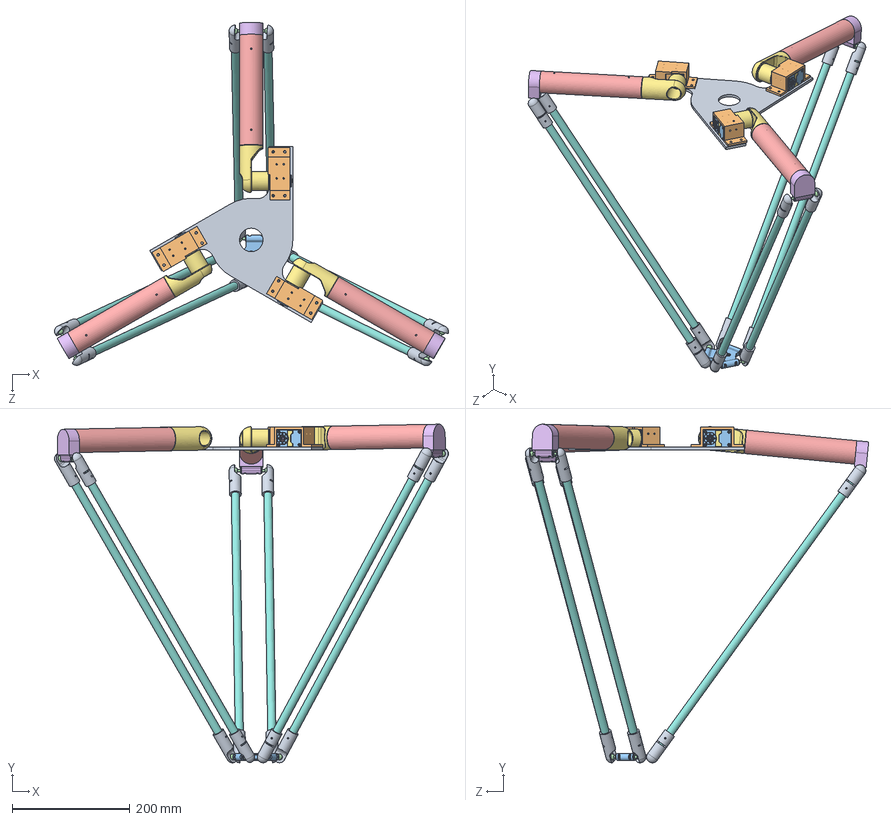
[picture p67: CAD file, 2024-04-09]
기타파일/로봇파트_수정본_A2/A2_deltarobot.SLDASM
668.5 x 574.5 x 582.6 mm
A2_윗삼각형_베이스
A1_플랜지 x 3
M_DC11_A01_IDLER.stp x 3
DC11_A01_HORN_INSERT_1.stp x 24
M_DC11_A01_IDLER_CAP.stp x 3
DC11_A01_IDLER_SCREW.stp x 3
M_DC11_A01_HORN.stp x 3
FHS_M2_5X06_NYLOK.stp x 3
DC11_B01_CASE_M_DUMMY.stp x 3
DC11_B01_CASE_F_DUMMY.stp x 3
DC11_B01_CASE_B_DUMMY2.stp x 3
PHS_M2_5X12_K.stp x 24
DX124_SCREW-COVER.stp x 3
DC11_A01_WIN_LED.stp x 3
DC11_A01_CVR_CABLE.stp x 3
DC14_A01_INSERT_1.stp x 3
B3B-EH.stp x 6
EHR-3.stp x 6
A1_아랫삼각형
A1_볼조인트_진짜최종 x 12
A1_윗링크_수정후_중간연결부 x 3
A1_윗링크_아래연결부 x 3
A1_윗링크_위쪽연결부 x 3
A1_아래링크 x 6
A1_아래링크_볼조인트_연결부 x 12
