dandeeAndy/CapstoneDesign/기타파일/로봇파트_수정본_A1/A1_아랫삼각형.SLDPRT

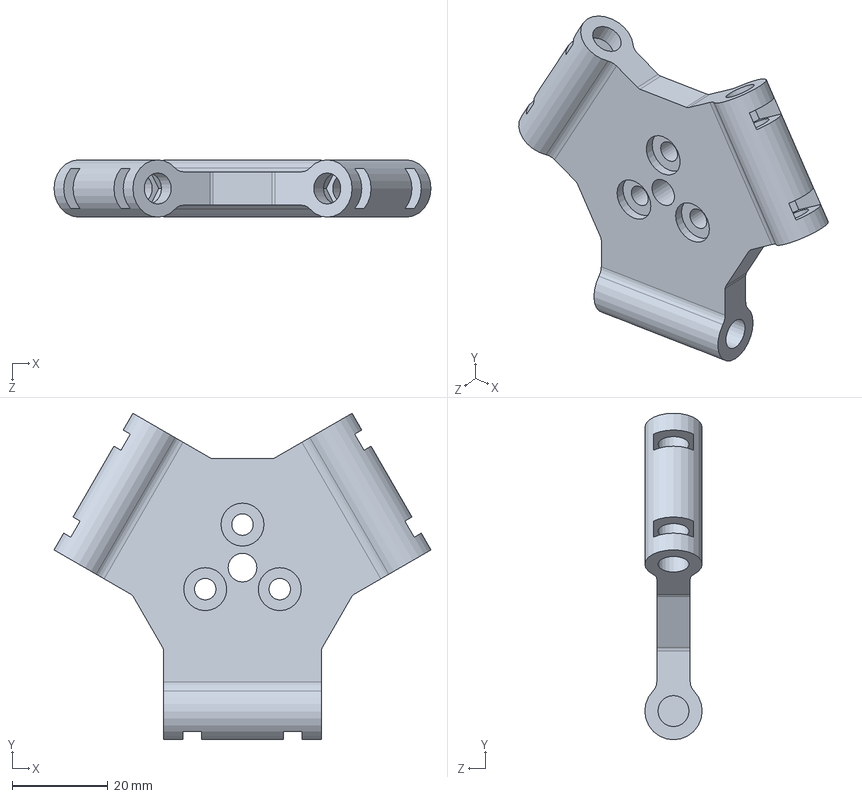
[picture p68: CAD file, 2024-04-09]
기타파일/로봇파트_수정본_A1/A1_아랫삼각형.SLDPRT
78.9 x 68.3 x 12.0 mm
