dandeeAndy/CapstoneDesign/기타파일/컨테이너.STL

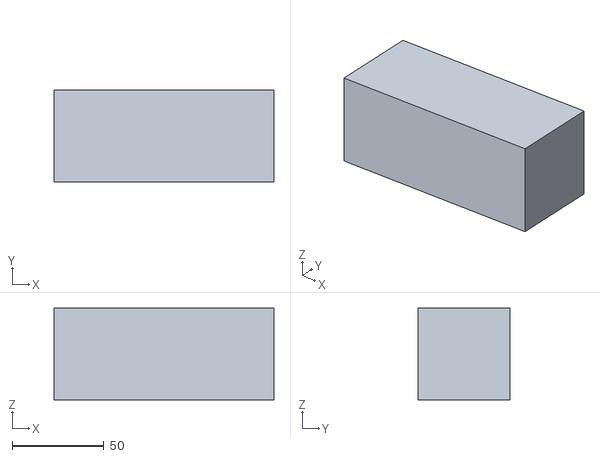
[picture p69: CAD file, 2024-02-02]
기타파일/컨테이너.STL
120.0 x 50.0 x 50.0
