dandeeAndy/CapstoneDesign/기타파일/로봇파트_수정본_A2/A1_플랜지.SLDPRT

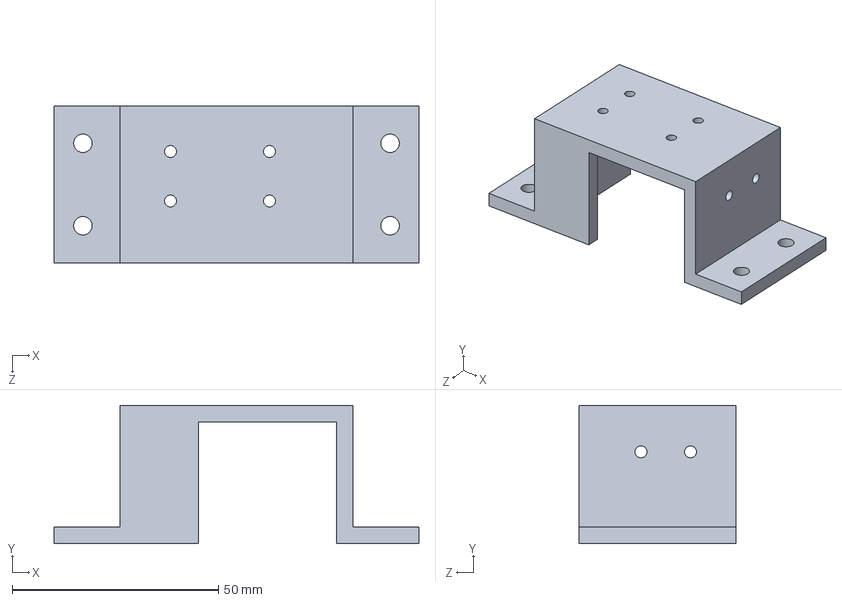
[picture p70: CAD file, 2024-04-09]
기타파일/로봇파트_수정본_A2/A1_플랜지.SLDPRT
88.5 x 33.5 x 38.0 mm
