dandeeAndy/CapstoneDesign/기타파일/로봇파트_수정본_A1/A1_볼조인트_진짜최종.SLDPRT

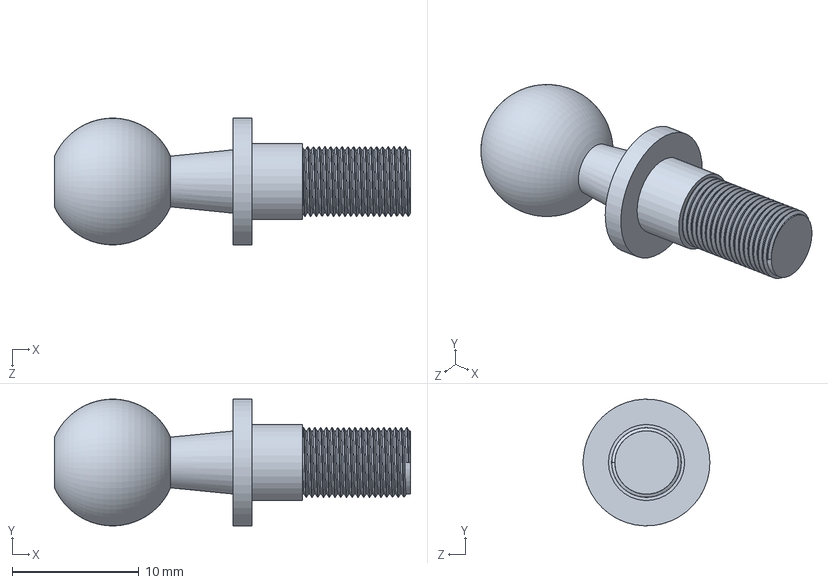
[picture p71: CAD file, 2024-04-09]
기타파일/로봇파트_수정본_A1/A1_볼조인트_진짜최종.SLDPRT
28.1 x 9.99 x 10.0 mm
