dandeeAndy/CapstoneDesign/기타파일/로봇파트_수정본_A2/A1_윗링크_수정후_중간연결부.SLDPRT

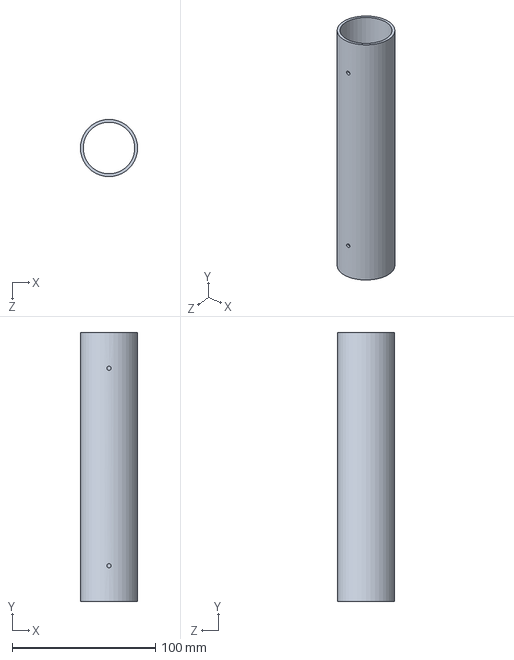
[picture p72: CAD file, 2024-04-09]
기타파일/로봇파트_수정본_A2/A1_윗링크_수정후_중간연결부.SLDPRT
40.0 x 188.0 x 40.0 mm
