dandeeAndy/CapstoneDesign/기타파일/로봇파트_수정본_A2/A1_윗링크_아래연결부.SLDPRT

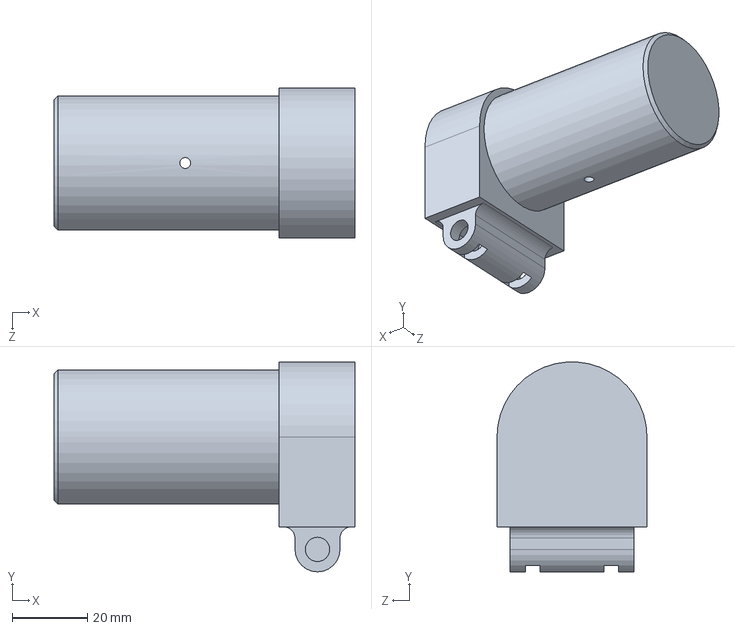
[picture p73: CAD file, 2024-04-09]
기타파일/로봇파트_수정본_A2/A1_윗링크_아래연결부.SLDPRT
80.3 x 55.9 x 40.0 mm
