dandeeAndy/CapstoneDesign/기타파일/로봇파트_수정본_A1/A1_윗링크_위쪽연결부.SLDPRT

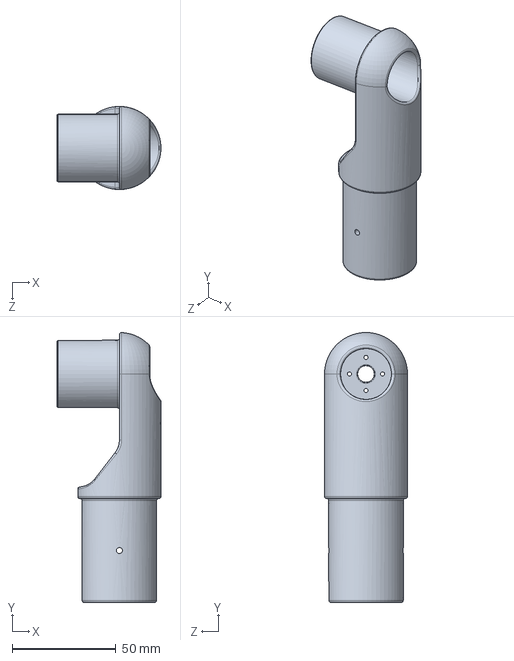
[picture p74: CAD file, 2024-04-09]
기타파일/로봇파트_수정본_A1/A1_윗링크_위쪽연결부.SLDPRT
50.0 x 130.0 x 40.0 mm
