dandeeAndy/CapstoneDesign/기타파일/로봇파트_수정본_A1/A1_윗삼각형_베이스_2.SLDPRT

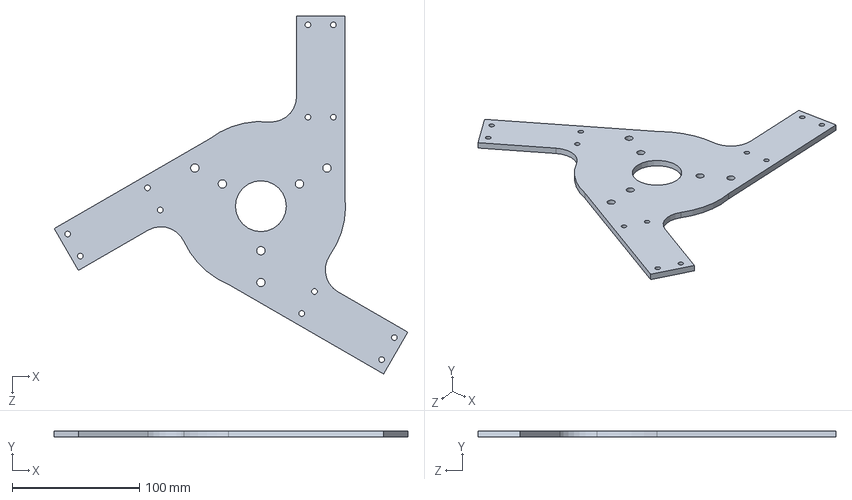
[picture p75: CAD file, 2024-04-09]
기타파일/로봇파트_수정본_A1/A1_윗삼각형_베이스_2.SLDPRT
278.0 x 5.00 x 281.5 mm
