dandeeAndy/CapstoneDesign/기타파일/로봇파트_수정본_A2/A2_윗삼각형_베이스.SLDPRT

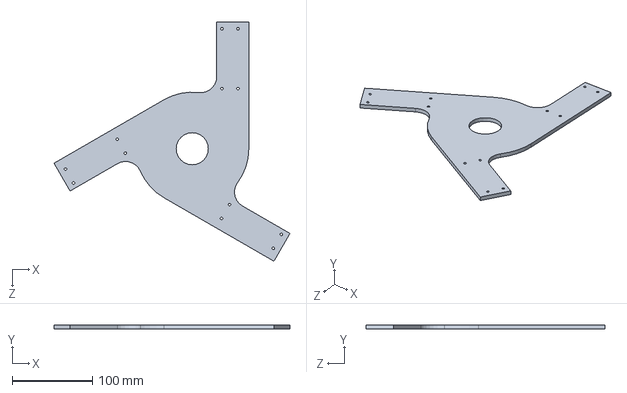
[picture p76: CAD file, 2024-04-09]
기타파일/로봇파트_수정본_A2/A2_윗삼각형_베이스.SLDPRT
294.1 x 5.00 x 298.4 mm
