dandeeAndy/CapstoneDesign/기타파일/로봇파트_수정본_A1/A1_아래링크_볼조인트_연결부.SLDPRT

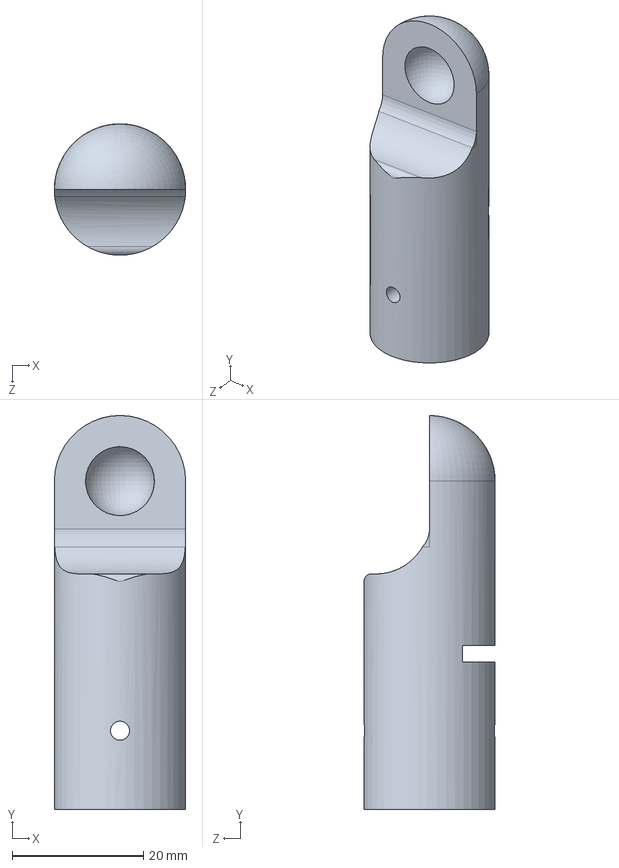
[picture p77: CAD file, 2024-04-09]
기타파일/로봇파트_수정본_A1/A1_아래링크_볼조인트_연결부.SLDPRT
20.0 x 60.0 x 20.0 mm
