dandeeAndy/CapstoneDesign/기타파일/로봇파트_수정본_A1/A1_플랜지.SLDPRT

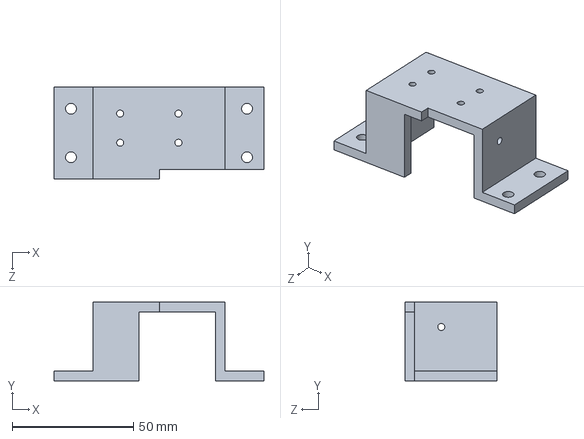
[picture p78: CAD file, 2024-04-09]
기타파일/로봇파트_수정본_A1/A1_플랜지.SLDPRT
86.5 x 32.5 x 38.0 mm
