dandeeAndy/CapstoneDesign/기타파일/로봇파트_수정본_A2/A1_아래링크.SLDPRT

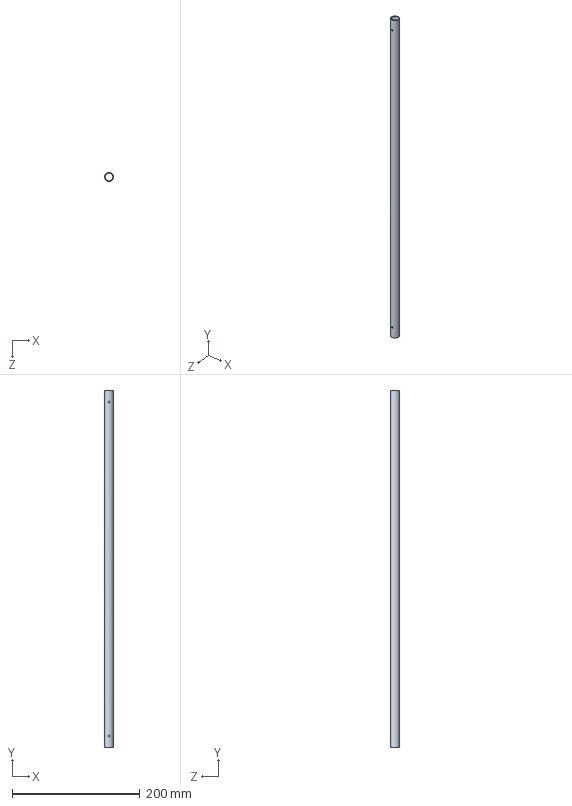
[picture p79: CAD file, 2024-04-09]
기타파일/로봇파트_수정본_A2/A1_아래링크.SLDPRT
14.0 x 560.0 x 14.0 mm
