dandeeAndy/CapstoneDesign/(list of files, cad)

Other CAD files:
기타파일/로봇파트_수정본_A2/A1_deltarobot_link_2.SLDASM
기타파일/로봇파트_수정본_A1/A1_deltarobot_link_1.SLDASM
기타파일/로봇파트_수정본_A2/A1_deltarobot_end.SLDASM
