dandeeAndy/CapstoneDesign/hanium/Perfect/solenoid.py

import serial

# Serial 통신을 설정하고 예외 처리를 추가합니다.
ser = serial.Serial('COM6', 9600, timeout=1)

def control_relay(state):
    if state:
        ser.write(b'1')  # Turn relay ON
    else:
        ser.write(b'0')  # Turn relay OFF

def airpump_off():
    control_relay(True)

def airpump_on():
    control_relay(False)
