dandeeAndy/CapstoneDesign/hanium/CustomCalibrationWrapper.cpp

/*
**********************************************************************************************************
*                                                                                                       **
* INTEL CONFIDENTIAL                                                                                    **
* Copyright (2018 - 2022) Intel Corporation.                                                            **
* This software and the related documents are Intel copyrighted materials, and your use of them is      **
* governed by the express license under which they were provided to you ("License"). Unless the License **
* provides otherwise, you may not use, modify, copy, publish, distribute, disclose or transmit this     **
* software or the related documents without Intel's prior written permission.                           **
* This software and the related documents are provided as is, with no express or implied warranties,    **
* other than those that are expressly stated in the License.                                            **
*                                                                                                       **
**********************************************************************************************************
*/

#include "CustomCalibration.h"
#include "CustomCalibrationWrapper.h"
#include "CalibParamXmlWrite.h"
#include <vector>

using namespace std;
using namespace cv;

#define ccwhandle ((CustomCalibrationWrapper*)handle)

namespace CustomCalibWrapper
{

CustomCalibrationWrapper::CustomCalibrationWrapper(string outputFolder, int chessboardWidth, int chessboardHeight, float chessboardSquareSize, int numCameras, int numImages)
{
	mOutputFolder = outputFolder;
	
	mCustomCalibratorData.chessboardSize = Size(chessboardWidth, chessboardHeight);
	mCustomCalibratorData.chessboardSquareSize = chessboardSquareSize;

	mCustomCalibratorData.corners.resize(numCameras);
	for (int i = 0; i < numCameras; i++)
		mCustomCalibratorData.corners[i].resize(numImages);
}

bool CustomCalibrationWrapper::AddImage(uint8_t* image, int width, int height, int stride, int cameraIndex, int imageIndex)
{
	Mat imgMat(Size(width, height), CV_8U, image, stride);
	return DetectChessboard(imgMat, mCustomCalibratorData.chessboardSize, mCustomCalibratorData.corners[cameraIndex][imageIndex]);
}

int CustomCalibrationWrapper::CalculateCalibration(int lrWidth, int lrHeight, int rgbWidth, int rgbHeight)
{
	try
	{
		bool hasRGB = mCustomCalibratorData.corners.size() > 2;
		
		Mat Kl, Dl, Kr, Dr, Rlr, Tlr;
		CalibrateDepthCamera(mCustomCalibratorData.corners[0], mCustomCalibratorData.corners[1], mCustomCalibratorData.chessboardSize, mCustomCalibratorData.chessboardSquareSize, Size(lrWidth, lrHeight), Kl, Dl, Kr, Dr, Rlr, Tlr);
		
		Mat Kc, Dc, Rlc, Tlc;
		if (hasRGB)
			CalibrateRGBCamera(mCustomCalibratorData.corners[0], mCustomCalibratorData.corners[2], mCustomCalibratorData.chessboardSize, mCustomCalibratorData.chessboardSquareSize, Size(rgbWidth, rgbHeight), Kl, Dl, Kc, Dc, Rlc, Tlc);
		else
		{
			Kc = Mat::zeros(3, 3, CV_64F);
			Dc = Mat::zeros(1, 5, CV_64F);
			Rlc = Mat::zeros(3, 3, CV_64F);
			Tlc = Mat::zeros(3, 1, CV_64F);
		}

		int resolutionLR[2] = { lrWidth, lrHeight };
		double focalLengthLeft[2] = { Kl.at<double>(0,0), Kl.at<double>(1,1) };
		double principalPointLeft[2] = { Kl.at<double>(0,2), Kl.at<double>(1,2) };
		double distortionLeft[5] = { Dl.at<double>(0,0), Dl.at<double>(0,1), Dl.at<double>(0,2), Dl.at<double>(0,3), Dl.at<double>(0,4) };
		double focalLengthRight[2] = { Kr.at<double>(0,0), Kr.at<double>(1,1) };
		double principalPointRight[2] = { Kr.at<double>(0,2), Kr.at<double>(1,2) };
		double distortionRight[5] = { Dr.at<double>(0,0), Dr.at<double>(0,1), Dr.at<double>(0,2), Dr.at<double>(0,3), Dr.at<double>(0,4) };

		double rotationLR[9] = { Rlr.at<double>(0,0), Rlr.at<double>(0,1), Rlr.at<double>(0,2), Rlr.at<double>(1,0), Rlr.at<double>(1,1),
			Rlr.at<double>(1,2), Rlr.at<double>(2,0), Rlr.at<double>(2,1), Rlr.at<double>(2,2) };
		double translationLR[3] = { Tlr.at<double>(0,0), Tlr.at<double>(1,0), Tlr.at<double>(2,0) };

		int resolutionRGB[2] = { rgbWidth, rgbHeight };
		double focalLengthRGB[2] = { Kc.at<double>(0,0), Kc.at<double>(1,1) };
		double principalPointRGB[2] = { Kc.at<double>(0,2), Kc.at<double>(1,2) };
		double distortionRGB[5] = { Dc.at<double>(0,0), Dc.at<double>(0,1), Dc.at<double>(0,2), Dc.at<double>(0,3), Dc.at<double>(0,4) };

		double rotationLC[9] = { Rlc.at<double>(0,0), Rlc.at<double>(0,1), Rlc.at<double>(0,2), Rlc.at<double>(1,0), Rlc.at<double>(1,1),
			Rlc.at<double>(1,2), Rlc.at<double>(2,0), Rlc.at<double>(2,1), Rlc.at<double>(2,2) };
		double translationLC[3] = { Tlc.at<double>(0,0), Tlc.at<double>(1,0), Tlc.at<double>(2,0) };

		string fileName = mOutputFolder + "/CalibrationParameters.xml";

		CalibParamXmlWrite::WriteCustomCalibrationParametersToFile(fileName, resolutionLR, focalLengthLeft, principalPointLeft, distortionLeft, focalLengthRight,
			principalPointRight, distortionRight, rotationLR, translationLR, hasRGB, resolutionRGB, focalLengthRGB, principalPointRGB,
			distortionRGB, rotationLC, translationLC);

		return 0;
	}
	catch (...)
	{
		return -1;
	}
}

}
