dandeeAndy/CapstoneDesign/(commit log)

2024-01-24 ip제거
    ㅁㄴㅇㄹ
2024-01-25 mainui불러오기 코드길이 줄이기
2024-01-25 다없앰
    안되는 self., 멀티쓰레딩, grpc통신 없앰
2024-01-25 불필요, 이미지 레이블
2024-01-29 아이콘 사진 추가
2024-01-29 1920/1080 검은 빈 화면
2024-01-30 깔끔하게 정리
    필요한 것만 남겨둠
2024-01-30 import 주석처리
2024-02-02 파일이동
    [컨테이너.STL]
2024-02-06 2월6일
2024-02-11 그림 추가
2024-02-11 이름 변경
2024-02-11 Delta_System 추가 및 python 파일 추가
2024-02-13 실행파일만들기
2024-02-13 사진다운로드
2024-02-15 UI파일이름변경
2024-02-15 Label작업1
2024-02-17 뤼튼이가 써준 코드
2024-02-23 2/23뤼튼 수정 미완료
2024-03-04 gpt 추가작업 hbox
2024-03-06 한이음사진
2024-03-09 사진 추가 및 정리
2024-03-09 사진 관련 README 생성
2024-03-09 해결시도코드
2024-03-12 gpt유료버전
2024-03-12 이벤트 필터링 기능
2024-03-12 새 파일
2024-03-12 파일 이동
2024-03-12 같은파일
2024-03-12 비슷한 파일
2024-03-14 그림자 없앤 버전
2024-03-14 승호 gpts로 만든 코드
2024-03-19 시스템로고 제작
2024-03-19 옵션 버튼 1차 수정
2024-03-19 구상도 임시 파일
2024-03-19 옵션 버튼 1차 완성
2024-03-19 현재 디렉토리 출력
2024-03-19 QPixmap 객체 상태 확인
2024-03-19 Opt출력 수정
2024-03-19 2차 수정
    옵션 버튼의 이름을 변경합니다.
    각 옵션 버튼이 클릭됐을 때 터미널에 "Opt1", "Opt2", "Opt3"을 출력합니다.
    세부항목 목록에 신호를 받으면 텍스트를 한 줄씩 출력할 수 있는 기능을 추가합니다.
    모든 레이블의 외형선을 검은색 선으로 그립니다.
2024-03-19 big edit1
    mousePressEvent 수정
2024-03-19 big edit 마지막
    물류 세부사항은 안되는데 옵션 이름 바꾸고, 출력 Opt로 되는거는 해결
2024-03-19 장애이력 항목추가
2024-03-19 이미지 파일 이동
2024-03-19 전체 수정(이미지 버튼)
2024-03-21 하드웨어 수정본
2024-03-21 KeepAspectRatio 1차수정
2024-03-25 카본파이프 견적서
2024-03-25 뤼튼 수정(QPixmap오류)
2024-03-26 Create 2024년도 공학설계 및 졸업설계운영방법.pdf
2024-03-26 통신코드 다운로드
2024-03-26 임시파일
2024-03-26 최대화까지
2024-03-26 위젯크기 측정
2024-03-26 구상도 이미지 임의 조정
2024-03-26 이미지 비율 수정
2024-03-26 타이머 삭제
2024-03-26 불필요한 부분 제거
2024-03-26 위치 크기 설정 수정
2024-03-27 수요일 근장 수정(코파일럿)
2024-03-27 뤼튼 테스트
2024-03-27 라운드+외형선 수정
2024-03-27 QSizePolicy.Fixed 크기고정
2024-03-27 QGridLayout추가
2024-03-27 QGridLayout테스트
2024-03-28 투명버튼존재 위치수정
2024-03-28 2차수정_안됨
2024-03-28 이게 진짜 2차수정_안됨
2024-03-28 3차수정_그냥 미침
2024-03-28 일단 옵션 구동 가능한거 따로 만듦
2024-03-28 옵션 버튼 사라짐
2024-03-28 버튼 이미지 조절 실패
2024-03-29 자료 다운로드
2024-03-29 금요일 수정
2024-04-01 그리드 작게 완성
2024-04-01 파일 옮기기
2024-04-01 폰트 설정
2024-04-01 QGridLayout 1차, 옵션 미완성
2024-04-01 QGridLayout 2차, 틀 완성, 옵션 미완성
2024-04-01 임시로 실행파일
2024-04-01 간단 수정
2024-04-01 시행착오 지우기
2024-04-01 QGridLayout 3차, 실행안됨
2024-04-01 QGridLayout 4차, 옵션 수정 안됨
2024-04-01 QGridLayout 5차, 세밀해짐
2024-04-02 퍼즈버튼 구현
2024-04-02 로고 사진 변경
2024-04-02 QGridLayout 6차, 토글 아직안됨
2024-04-02 사진추가
2024-04-02 QGridLayout 7차 완전굿
2024-04-02 QGridLayout 8차 수정
2024-04-02 옵션 완성
2024-04-02 물류 세부사항 뜨게하기
2024-04-03 로고 제작
2024-04-03 QGridLayout 수정
2024-04-03 spacer_label 추가만_수정필요
2024-04-03 기타 견적서 파일
    [졸업설계소요재료신청서(졸설2차).xlsx, 졸업설계소요재료신청서(팀장이름) (1).xlsx, 졸업설계소요재료신청서(한이음).xlsx]
2024-04-03 QGridLayout 9차 수정
    장애이력, 세부사항 항목별로 그리드 다시 나눠야함
2024-04-04 통신, 쓰레드 추가
2024-04-04 callback 함수 추가
2024-04-04 승호 코드 추가
2024-04-04 Create [공지] 2024년 한이음 ICT멘토링 이용자 매뉴얼.pdf
2024-04-04 업데이트
2024-04-04 수정작업
2024-04-08 QGridLayout 세부화 수정1
2024-04-09 수정필요한 글로벌변수로 수정
2024-04-09 GOOD_되는거
2024-04-09 여러가지 함수 추가 수정
2024-04-09 label_8 장애이력 추가
2024-04-10 QR_add추가 option_buttons불러오는거 안됨
2024-04-10 오류는 동일함 조금 수정
2024-04-25 목요일 오류수정중
2024-04-29 안됨 reset전
2024-04-29 월요일 업데이트
2024-04-30 화요일 1차 업뎃
2024-04-30 화요일 2차 업뎃(옵션작동성공)
2024-04-30 화요일 수정본
2024-05-01 수요일 수정1차
2024-05-01 수정추가
2024-05-01 수요일 수정 2차
2024-05-01 수요일 수정 3차
2024-05-01 수요일 4차 수정
2024-05-02 목요일 수정 1차
2024-05-02 목요일 수정 2차 pause추가
2024-05-02 목요일 수정 3차
2024-05-04 새로 업데이트 5/2
2024-05-05 classifi 저장(widget->label)
2024-05-07 test_thread 추가
2024-05-07 물품정보 뜨는거!!!
2024-05-07 최종 수정중
2024-05-08 이미지 수정
2024-05-08 로고 이미지 업데이트
2024-05-08 깔끔 수정 및 UI작업 위한 코드
2024-05-09 reset 추가
2024-05-13 5.13 수정
2024-05-14 5.14 조금 수정
2024-05-14 5.14 수정
2024-05-15 UI 두 번 뜨는 오류 수정
2024-05-15 update_labels 삭제 및 이름 고정
2024-05-15 ABABAB로 수정
2024-05-15 5/15 수정
2024-05-15 5/15 통신코드 수정
2024-05-16 5/16 수정setButtonSize 제거전
2024-05-18 5/18 수정
    [기계 - 졸업설계 종합발표 순서[2024년1학기].xls]
2024-05-18 수정 및 거의 완성
2024-05-18 오류수정
2024-05-18 5/18 완벽?
2024-05-19 수정 추가
2024-05-19 5/19 작업
2024-05-19 5/19 수정
2024-05-19 5/19 수정2
2024-05-20 5/20 수정
    [기계 - 졸업설계 종합발표 순서[2024년1학기].xls]
2024-05-20 5/19 추가 수정
2024-05-21 5/21 최종
2024-05-21 5/21 수정
2024-05-27 보고서 진행
2024-06-13 마무리중
2024-08-04 파일 위치 정리
2024-08-04 버전 기록
2024-08-26 8.26_1차
2024-08-26 8.26_2차(전역변수->인스턴스변수)
2024-08-26 8.26_3차
2024-08-26 8.26_4차(Flask시작)
2024-08-27 8.27_1차(app.py첫수정)
2024-08-27 8.27_2차
2024-09-19 파일 동기화
    [qr_data.xlsx]
2024-09-25 모터4개 확인
2024-09-25 0925업뎃
2024-09-26 영위치추가
2024-09-26 minus 추가
2024-09-28 pdf 다운로드
2024-09-28 andy이동
2024-09-28 한이음 1차자료 정리
2025-09-23 인텔리얼센스(비전)툴박스
    [qr_data.xlsx, 방을잡자.xlsx]
2025-09-23 비전TRY-환경 바꿈
2025-09-23 미니pc 필요한것만 옮김
2025-09-23 파일 옮김
2025-09-23 일단 저장
2025-09-23 1008저장
2025-09-23 motor control 역기구학 결합
2025-09-23 계산 시간 단축화
2025-09-23 추가 수정
2025-09-23 아침 수정
2025-09-23 공백 수정
