dandeeAndy/CapstoneDesign/hanium/엑스포/20241208_232546.jpg

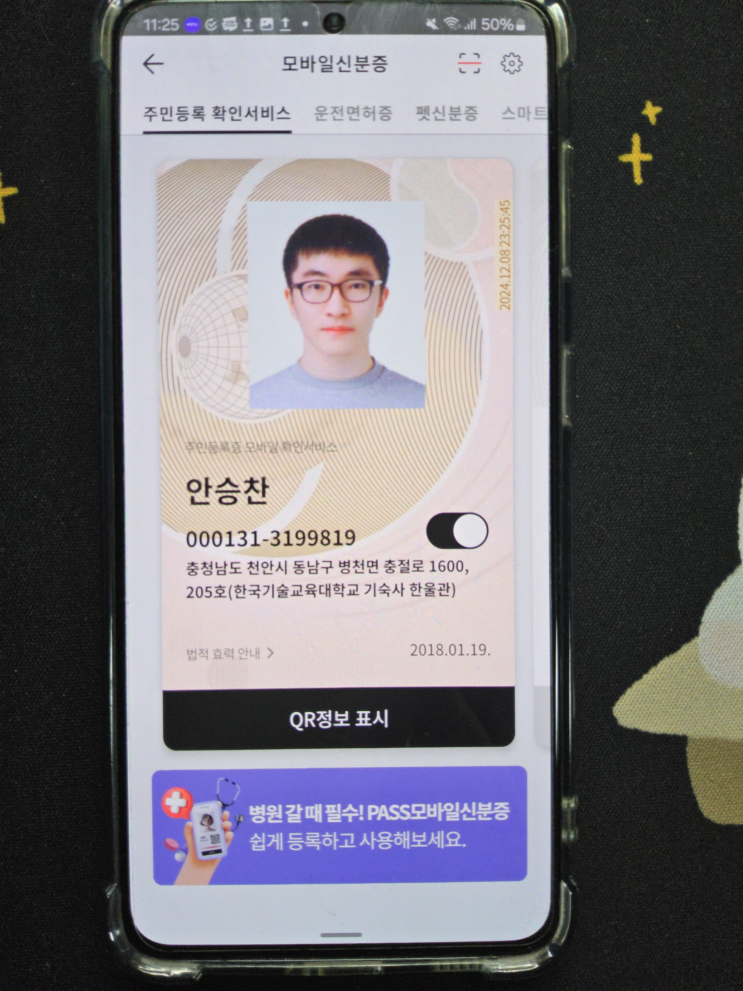
hanium/엑스포/20241208_232546.jpg
